pinguinonice/BetaBMI055/README.md

# BetaBMI055
IMU WiFi-Sensorboard - BETA

Das Sensorboard ermöglicht es Beschleunigungen und Drehraten des BMI055 IMU Sensors  kabellos, über ein WiFi-Netzwerk zu übertragen. Die Stromversorgung erfolgt durch einen Lithium-Polymer Akku und lässt so einen Messbetrieb über mehrere Stunden zu. Der Ladestand des Akkus kann ebenfalls ausgelesen und übertragen werden. Als Microcontroler und WiFi-Modul dient ein ESP-12F. Als Lade- und Programmierschnittstelle dient ein Micro USB Anschluss. 2 LEDs können als Statusanzeige verwendet werden eine weitere dient als Ladeindikator.
In diesem Dokument soll gezeigt werden, wie Programme auf das Board mit Hilfe der Arduino IDE aufgespielt werden können. Ein Programmbeispiel 2 zur Übertragung der Messdaten an MATLAB liegt vor.
