pinguinonice/BetaBMI055/v2/main.tex

%%%%%%%%%%%%%%%%%%%%%%%%%%%%%%%%%%%%%%%%%
% Wenneker Article
% LaTeX Template
% Version 2.0 (28/2/17)
%
% This template was downloaded from:
% http://www.LaTeXTemplates.com
%
% Authors:
% Vel (vel@LaTeXTemplates.com)
% Frits Wenneker
%
% License:
% CC BY-NC-SA 3.0 (http://creativecommons.org/licenses/by-nc-sa/3.0/)
%
%%%%%%%%%%%%%%%%%%%%%%%%%%%%%%%%%%%%%%%%%

%----------------------------------------------------------------------------------------
%	PACKAGES AND OTHER DOCUMENT CONFIGURATIONS
%----------------------------------------------------------------------------------------

\documentclass[10pt, a4paper, onecolumn]{article} % 10pt font size (11 and 12 also possible), A4 paper (letterpaper for US letter) and two column layout (remove for one column)

\input{structure.tex} % Specifies the document structure and loads requires packages
\usepackage{units}   % für nicht-kursive Einheiten
%----------------------------------------------------------------------------------------
%	ARTICLE INFORMATION
%----------------------------------------------------------------------------------------

\title{IMU WiFi-Sensorboard - BETA} % The article title

\author{
	\authorstyle{Karsten Schäfer\textsuperscript{1,3}, Bernhardt Schäfer\textsuperscript{1,2}, Markus Mroch\textsuperscript{1,3} und Philipp Schneider\textsuperscript{1,2}} % Authors
	\newline\newline % Space before institutions
\textsuperscript{1}\institution{Universität Stuttgart}\\ % Institution 1
\textsuperscript{2}\institution{Institut für Navigation} \\
\textsuperscript{3}\institution{Institut für Sportwissenschaften} % Institution 3
}

% Example of a one line author/institution relationship
%\author{\newauthor{John Marston} \newinstitution{Universidad Nacional Autónoma de México, Mexico City, Mexico}}

\date{\today} % Add a date here if you would like one to appear underneath the title block, use \today for the current date, leave empty for no date

%----------------------------------------------------------------------------------------

\begin{document}

\maketitle % Print the title

\thispagestyle{firstpage} % Apply the page style for the first page (no headers and footers)

%----------------------------------------------------------------------------------------
%	ABSTRACT
%----------------------------------------------------------------------------------------

Das Sensorboard ermöglicht es Beschleunigungen und Drehraten des BMI055 IMU Sensors (\ref{BMI055}) kabellos, über ein WiFi-Netzwerk zu übertragen. Die Stromversorgung erfolgt durch einen Lithium-Polymer Akku und lässt so einen Messbetrieb über mehrere Stunden zu. Der Ladestand des Akkus kann ebenfalls ausgelesen und übertragen werden. Als \emph{Microcontroler} und WiFi-Modul dient ein ESP-12F (\ref{ESP-12F}). Als Lade- und Programmierschnittstelle dient ein \emph{Micro USB Anschluss}  2 LEDs können als Statusanzeige verwendet werden eine weitere dient als Ladeindikator. 

In diesem Dokument soll gezeigt werden, wie Programme auf das Board mit Hilfe der Arduino IDE aufgespielt werden können. Ein Programmbeispiel \ref{Beispiele}  zur Übertragung der Messdaten an MATLAB liegt vor.

%----------------------------------------------------------------------------------------
%	ARTICLE CONTENTS
%----------------------------------------------------------------------------------------

\tableofcontents

\clearpage
\section{Aufbau}

Das Sensorboard wurde entworfen um zwei verschiedene MEMS IMU Sensoren benutzen zu können. Die hier beschrieben Variante ist ausschließlich mit dem Bosch BMI055 \cite{BMI055} bestückt. 

%------------------------------------------------

\subsection{Übersicht}
\begin{figure}[h]
	\centering
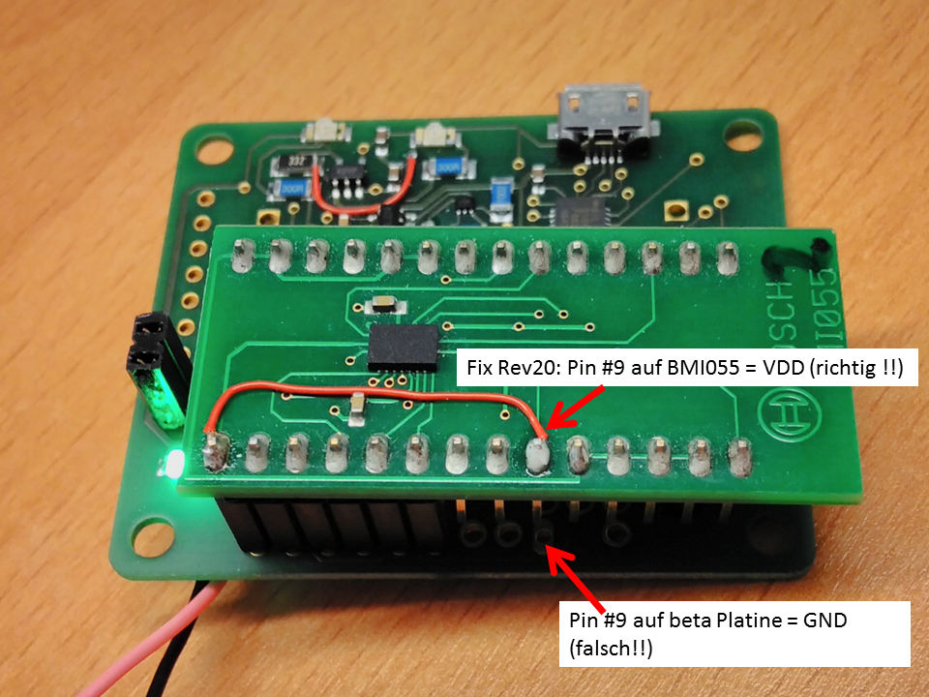
[picture p1: v2/images/BetaICMRev020fix.png]
	
	\caption{Übersicht mit nachträglichen Verbindungen}
	\label{fotoBeta}
\end{figure}

\clearpage
%------------------------------------------------

\subsection{Schaltplan}
Abbildung \ref{schematicBeta} zeigt den Schaltplan des Sensorboards. Zu beachten ist, dass der Sensor \emph{ICM2061 } nicht bestückt ist.\\ \textbf{$I^2C$ Betrieb}    GPIO4 = SDA und GPIO5 =SCL  
\begin{figure}[h]
	\centering
	
	\caption{Schaltplan des Sensorboards (ICM2061 ist nicht bestückt)}
	\label{schematicBeta}
\end{figure}

\clearpage

\subsection{Platine}
Abbildung \ref{platineBeta} zeigt die Abmessungen und den Aufbau der Platine

\begin{table}[h]
	\begin{tabular}{ll}
	
		~  & Bezeichnung\\
		\midrule
		1 & ESP-12F (\ref{ESP-12F})  \\
		2 & Fuelegauge (\ref{fuelgauge}) \\
		3 & LED D2 (\ref{LEDs})  \\
		4 & Reset (\ref{reset})  \\
		5 & FTDI Anschluss (\ref{FTDI}) \\
		6 & LED D1 (\ref{LEDs})  \\
		7 & Micro USB Anschluss  \\
		8 & CP2104 (\ref{CP2104}) \\
		9 & LED D3 (\ref{LEDs})  \\
		10 & Solderbridge (\ref{CP2104})  \\
		\bottomrule
	\end{tabular}
\end{table}

\begin{figure}[h]
	\centering
	
	\caption{Platinen Layout ohne Sensor. \colorbox{red}{ROT}=Oben,\colorbox{blue}{Blau}=Unten, \colorbox{Green}{Grün}=Durchkontaktierung}
	\label{platineBeta}
\end{figure}

%------------------------------------------------
\clearpage

\section{Beispielanwendung} \label{Beispiele}
Im Folgenden sollen ein paar Beispiel Anwendungen gezeigt werden. Um den Code auf das Sensorboard zu \emph{Flashen} wird die Arduino IDE benötigt. Für Arduino Projekte gibt es eine große \emph{Community}, sodass die meisten Probleme durch einer kurzen Internetrecherche lösbar sind. 

\subsection{LED Test}
Der folgende Arduino Sketch testet die Funktion der LEDs.
Die Pins GPIO0 GPIO2 und GPIO13 dienen hierbei als Sink für die LED, d.h. LOW = An.\\
GPI014 muss für den Batteriebetrieb HIGH sein.
\lstinputlisting[style=Arduino]{code/Blink2LED02/Blink2LED02.ino}

\subsection{I$^2$C Scanner}

Dieser Sketch kann verwendet werden um nach über den $I^2C$-Bus angeschlossenen Sensoren zu Suchen. Im Serial Monitor der ARDUINO IDE  sollten folgende Adressen gefunden werden 0x18, 0x68 und 0x36 das sind Beschleunigungssensor \& Gyroskop (\ref{BMI055}) und Fuelgauge (\ref{fuelgauge}).

\lstinputlisting[style=Arduino]{code/i2cScanner/i2cScanner.ino}

\subsection{Übertragen des Signals via Wi-Fi}
Eine Möglichkeit die Messdaten auf einen Computer mit Matlab zu übertragen soll hier gezeigt werden.
Der Computer und der Sensor müssen imselben WiFi Netzwerk sein (z.B. WiFi-Hotspot mit Handy). Um den Sensor mit dem gewünschten Netz zu verbinden müssen im Sketch SSID und Passwort (Zeile 27-28) angepasst werden. Nach einem Reset wird über den Seriellen Monitor der Status der Verbindung angegeben. Ist der Sensor verbunden, leuchtet die grüne LED.
Das Matlab file sollte die eingehenden UDP Verbindungen Verarbeiten. 

\subsubsection{Übertragungsstruktur}
Jede Messung besteht aus 16 Byte. int32 (4 Byte) für die Zeit int16 (2  Byte) für die Beschleunigung jeder Achse und  int16 (2 Byte) für die Drehrate jeder Achse.   \\
Es werden immer 10 Messungen gemeinsam mit der Signalstärke des Wi-Fis (int32 4 Byte) und dem Ladezustand der Batterie (int8 1 Byte) übertragen, sodass das gesammte Packet $16 \cdot 10 + 5 = $ 165 Byte lang ist.\\
{\tiny 
\begin{tabular}{llllllllllllllllllllll} \toprule
	{1} & {2} & {3} & {4} & {5} & {6} & {7} & {8} & {9} & {10} & {11} & {12} & {13} & {14} & {15} & {16}& {...} &{161}& {162} & {163} & {164} & {165} \\ \midrule
	{$t_1$} & {$t_2$} & {$t_3$} & {$t_4$} & {$ax_1$} & {$ax_2$} & {$ay_1$} & {$ay_2$} & {$az_1$} & {$az_2$} &  {$ax_1$} & {$gx_2$} & {$gy_1$} & {$gy_2$} & {$gz_1$} & {$gz_2$}& {...} & {$wifi_1$} & {$wifi_2$} & {$wifi_3$} & {$wifi_4$} & {bat}\\  \bottomrule
\end{tabular}}
 {\normalsize }\\
 
 Die Werte werden im Matlab Skript  (Zeile 40-50) zusammengesetzt.
\subsubsection{Matlab Code}

\definecolor{gray}{rgb}{0.95,0.95,0.95}
\definecolor{mgreen}{rgb}{0.1,0.5,0.1}  %Matlab-Grün
\lstset{
	breaklines=true,
	inputencoding="latin1",
	backgroundcolor=\color{gray},
	basicstyle=\scriptsize\ttfamily,
	commentstyle=\color{mgreen}\ttfamily,
	emph={square}, 
	emphstyle=\color{blue}\texttt,
	emph={[2]root,base},
	emphstyle={[2]\color{yac}\texttt},
	showstringspaces=false,
	flexiblecolumns=false,
	tabsize=4,
	numbers=left,
	numberstyle=\tiny,
	numberblanklines=false,
	stepnumber=1,
	numbersep=10pt,
	xleftmargin=15pt
}
\lstinputlisting[language=matlab]{code/betareadout/betareadout.m}

\subsubsection{ Arduino Sketch}
Dieser Sketch 
\lstinputlisting[style=Arduino]{code/test_BETA/test_BETA.ino}

\section{Komponenten}

\subsection{ESP-12F}
\label{ESP-12F}
Das ESP8266 Modul ist ein Ultra-low-Power-32-Bit-Mikrocontroller.  Integriertes WLAN ermöglicht die Kommunikation nach Außen.  
Die Programmierung kann z.B. über die ARDUINO-IDE vorgenommen werden. Die Sensoren (IMU, Batteriestand) sind über einen $I^2C$-Bus angeschlossen.
\begin{description}
	\item[WiFi Protocles] 802.11 b/g/n
	\item[Frequency Range ] 2.4GHz-2.5GHz (2400M-2483.5M)
	\item[Security] WPA/WPA2  WEP/TKIP/AES
	\item[Stromverbrauch] 80 mA
	\item[Network Protocols] IPv4, TCP/UDP/HTTP/FTP
\end{description}
\subsection{BMI055}
\label{BMI055}
Der BOSCH BMI055 ist eine Inertiale Messeinheit (IMU) und somit  eine räumliche Kombination von Beschleunigungssensoren  und Drehratensensoren. Die Messungen erfolgen in x-, y- und z- Richtung und realisieren so  6 Freiheitsgrade (6DoF). 

\paragraph{Accelerometer}
\begin{description}
	\item[I2C Adresse] 0x18
	\item[Auflösung] 12bit
	\item[Messbereich ] Programmierbar:  ±2g/±4g/±8g/±16g
	\item[Stromverbrauch] 130 $\mu$A
\end{description}
\paragraph{Gyroskop}
\begin{description}
\item[I2C Adresse] 0x68
\item[Auflösung] 16bit
\item[Messbereich ] Programmierbar:  ±125°/s to ±2000°/s
\item[Stromverbrauch] 5mA 
\end{description}
\subsection{Fuelgauge}
\label{fuelgauge}
Der Batteriestandsanzeiger MAX17048 bietet die Möglichkeit den Ladestand eines LiPo-Akkus (1 Zelle, 3.7V) in Prozent abzufragen.  Interne wird die Spannung in eine einem Model in Prozent umgerechnet, dabei werden spezifische Effekte der Batterie, wie Temperatur und Spannungskurve berücksichtigt.
\begin{description}
		\item[I2C Adresse] 0x36
	\item[Precision]  ±7.5mV
	\item[Stromverbrauch] <23$\mu$A
\end{description}

\subsection{LEDs}
\label{LEDs}
Das Board verfügt über 3 LEDs von denen 2 über die GPIOs des ESP8266 Moduls frei programmierbar sind. Eine LED ist als Ladeindikator vorgesehen.

\begin{table}[h]
	\caption{LEDs}
	\centering
	\begin{tabular}{llr}
		Name & Anschluss & Farbe \\
		\midrule
		D1 & GPIO0 & ??? \\
		D2 & GPIO13 & ??? \\
		D3 & Ladestand & ??? \\
		\bottomrule
	\end{tabular}
\end{table}

LED D1 blinkt wenn Kommunikation über die UART Schnittstelle stattfindet.

\subsection{CP2104 }
\label{CP2104}
CP2104 Chip als USB/UART Bridge für die Programmierung. Treiber sind für alle gängigen Betriebssystem vorhanden. RXD und TXD können ggf. manuell getrennt werden (Siehe \emph{Solderbridge} Abb. \ref{platineBeta}).

\subsection{FTDI Anschluss }
\label{FTDI}
Anschluss für 5 Volt FTDI Kabel (GND, CTS, VCC, TXD, RXD, RTS). Kann auch zum laden des Akkus verwendet werden.

\subsection{Reset}
\label{reset}
\blindtext

\section{Anhang}
\subsection{Bibliotheken}
\subsubsection{BMI055}
\lstinputlisting[style=arduino]{code/test_BETA/BMI055.cpp}
\subsubsection{BMI055.h}
\lstinputlisting[style=arduino]{code/test_BETA/BMI055.h}

\subsubsection{I2Cdev}
https://github.com/jrowberg/i2cdevlib/blob/master/Arduino/I2Cdev/I2Cdev.h
\subsubsection{MAX17048}
https://github.com/libpropeller/libpropeller/blob/master/libpropeller/max17048/max17048.h
%----------------------------------------------------------------------------------------
%	BIBLIOGRAPHY
%----------------------------------------------------------------------------------------
\printbibliography[title={Datenblätter}] % Print the bibliography, section title in curly brackets

%----------------------------------------------------------------------------------------

\end{document}
