pinguinonice/BetaBMI055/v2/main.pdf

# IMU WiFi-Sensorboard - BETA

## Karsten Schafer ¨

## 1,3, Bernhardt Schafer ¨

## 1,2, Markus Mroch¹,3 und Philipp Schneider¹,2

1Universitat Stuttgart ¨

2
Institut fur Navigation ¨
3
Institut fur Sportwissenschaften ¨

## October 24, 2017

Das Sensorboard ermöglicht es Beschleunigungen und Drehraten des BMI055 IMU Sensors (3.2) kabellos, über ein WiFi-Netzwerk zu übertragen. Die Stromversorgung erfolgt durch einen Lithium-Polymer Akku und lässt so einen Messbetrieb über mehrere Stunden zu. Der Ladestand des Akkus kann ebenfalls ausgelesen und übertragen werden. Als Microcontroler und WiFi-Modul dient ein ESP-12F (3.1). Als Lade- und Programmierschnittstelle dient ein Micro USB Anschluss 2 LEDs können als Statusanzeige verwendet werden eine weitere dient als Ladeindikator. In diesem Dokument soll gezeigt werden, wie Programme auf das Board mit Hilfe der Arduino IDE aufgespielt werden können. Ein Programmbeispiel 2 zur Übertragung der Messdaten an MATLAB liegt vor.

# Contents

1 Aufbau | 2
2 Beispielanwendung | 5
3 Komponenten | 10
4 Anhang | 11

## IMU WiFi-Sensorboard - BETA

### 4.1.4 BMI055.h | 38

# 1 Aufbau

Das Sensorboard wurde entworfen um zwei verschiedene MEMS IMU Sensoren benutzen zu können. Die hier beschrieben Variante ist ausschließlich mit dem Bosch BMI055 [1] bestückt.

## 1.1 Ubersicht ¨

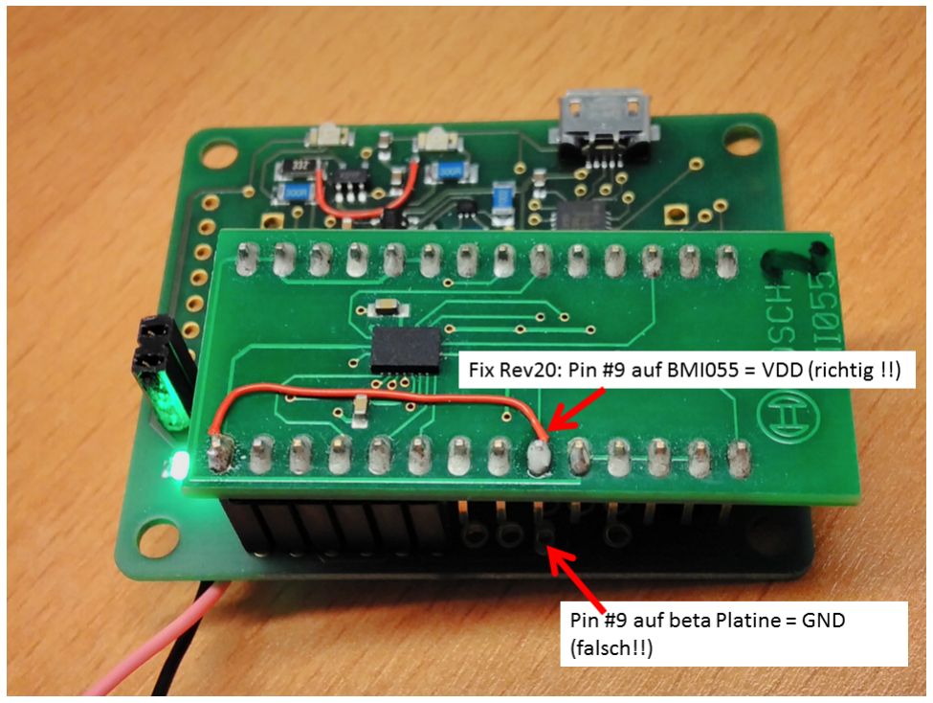
[picture p2: figure]

### Abb. 1: Übersicht mit nachträglichen Verbindungen

## 1.2 Schaltplan

Abbildung 2 zeigt den Schaltplan des Sensorboards. Zu beachten ist, dass der Sensor ICM2061 nicht bestückt ist.

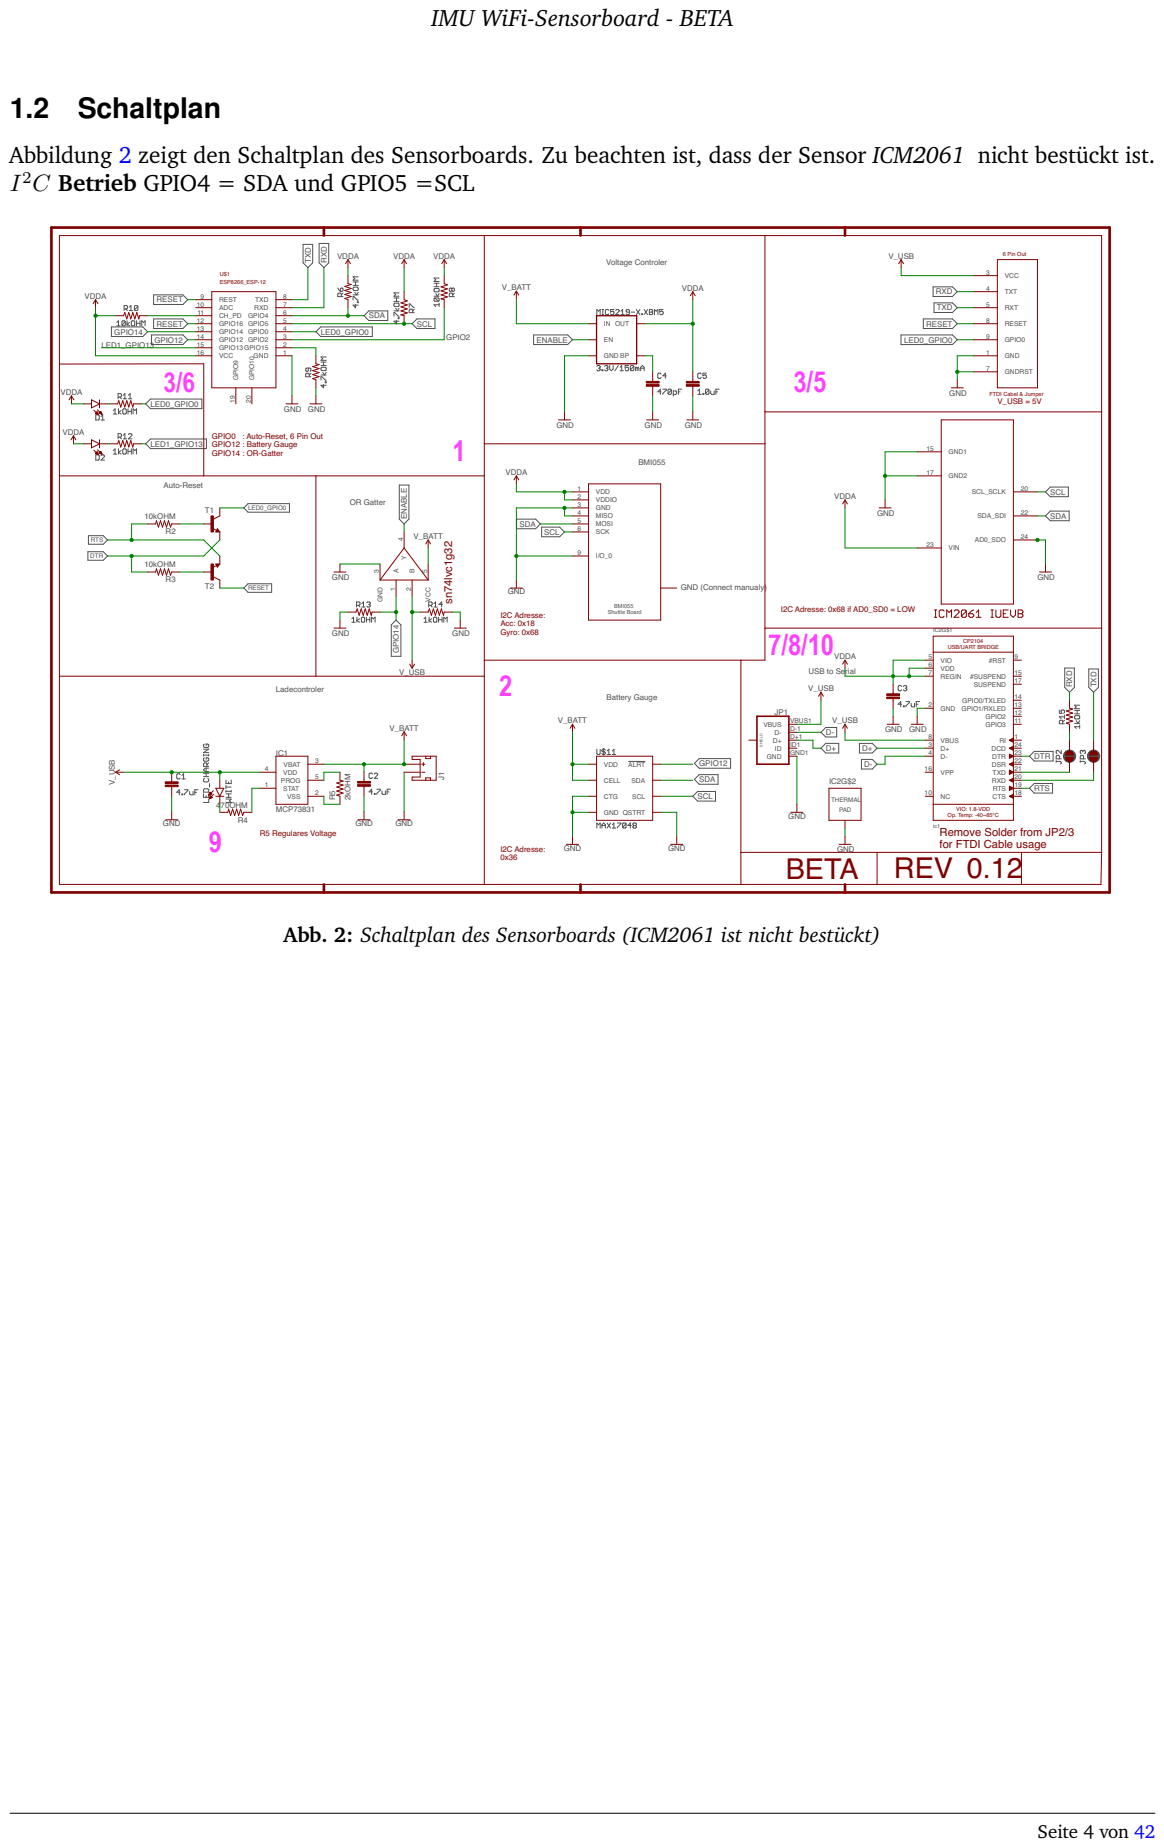
[picture p3: page 4]
MCP73831; GND; V_USB; V_BATT; 2kOHM; 470OHM; 10kOHM; VDDA; GND GND; BMI055; Ladecontroler; Auto-Reset; Battery Gauge; Voltage Controler; OR Gatter; VDD 4; STAT 1; VBAT; PROG; VSS; ALRT; CELL; CTG; GND QSTRT; SCL; SDA; VDD; VCC 5; GND 3; GND1 ID; VBUS; VBUS1; SHIELD; OUT; #RST; #SUSPEND; CTS; DCD; DSR; 22 DTR; GND 2; GPIO0/TXLED; GPIO1/RXLED; GPIO2; GPIO3; REGIN 7; RTS; 19 RXD; SUSPEND; TXD; VBUS 8; VDD 6; VIO 5; VPP 16; THERMAL; PAD; GND1 15; GND2 17; SCL_SCLK; SDA_SDI; VIN 23; AD0_SDO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

2C Betrieb GPIO4 = SDA und GPIO5 =SCL

FTDI Cabel & Jumper
V_USB = 5V

GPIO0 : Auto-Reset, 6 Pin Out
GPIO12 : Battery Gauge
GPIO14 : OR-Gatter

GND (Connect manualy)

I2C Adresse: 0x68 if AD0_SD0 = LOW I2C Adresse:
Acc: 0x18
Gyro: 0x68

USB/UART BRIDGE

USB to Serial

VIO: 1.8-VDD
Op. Temp: -40~85°C
Remove Solder from JP2/3
for FTDI Cable usage

Abb. 2: Schaltplan des Sensorboards (ICM2061 ist nicht bestückt)

## 1.3 Platine

### Abbildung 3 zeigt die Abmessungen und den Aufbau der Platine

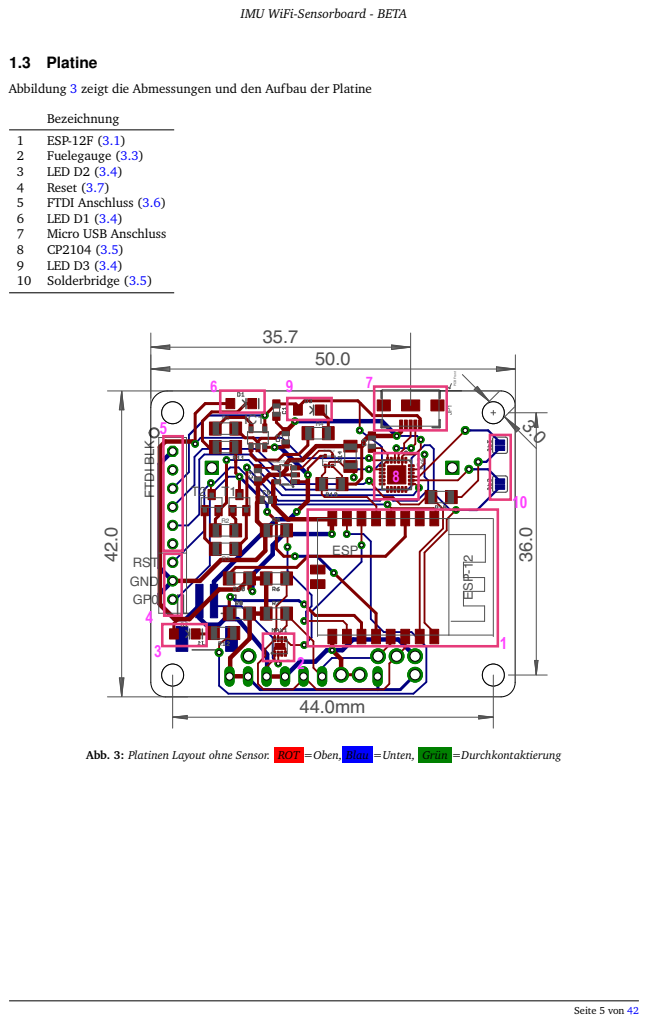
[picture p4: page 5]

Abb. 3: Platinen Layout ohne Sensor. ROT =Oben, Blau =Unten, Grün =Durchkontaktierung

# 2 Beispielanwendung

Im Folgenden sollen ein paar Beispiel Anwendungen gezeigt werden. Um den Code auf das Sensorboard zu Flashen wird die Arduino IDE benötigt. Für Arduino Projekte gibt es eine große Community, sodass die meisten Probleme durch einer kurzen Internetrecherche lösbar sind.

## 2.1 LED Test

Der folgende Arduino Sketch testet die Funktion der LEDs. Die Pins GPIO0 GPIO2 und GPIO13 dienen hierbei als Sink für die LED, d.h. LOW = An.
GPI014 muss für den Batteriebetrieb HIGH sein.
1 | #d e fi n e LED0 0
2 | #d e fi n e LED1 2
3 | #d e fi n e LED2 13
4 | #d e fi n e GPIO14_OR 14

5

6
7 | void se tup ( ) {
8 | pinMode (LED0 , OUTPUT) ;
9 | pinMode (LED1 , OUTPUT) ;
10 | pinMode (LED2 , OUTPUT) ;
11 | pinMode (GPIO14_OR , OUTPUT) ;
12 | d i g i t a l W r i t e (GPIO14_OR , HIGH) ; | // always on
13 | S e r i a l . begin (115200) ;
14 | }

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

39
40 }

## 2.2 I²C Scanner

### Dieser Sketch kann verwendet werden um nach über den I

### 2C-Bus angeschlossenen Sensoren zu Suchen. Im

Serial Monitor der ARDUINO IDE sollten folgende Adressen gefunden werden 0x18, 0x68 und 0x36 das sind Beschleunigungssensor & Gyroskop (3.2) und Fuelgauge (3.3).

1
2 | //
3 | // Thi s s ke t c h t e s t s the s t and a rd 7−b i t a d d re s se s
4 | // Devi ce s wi th hi g he r b i t add re s s might no t be seen p r o p e rl y .
5 | //

6
7 | #i n cl u d e <Wire . h> // i 2 c l i b a r y

8

9
10 | void se tup ( )
11 | {

12 | Wire . begin (5 ,4 ) ; // i 2 c Bus : | GPIO5 =SCL und GPIO4 = SDA

13

14

15
16 | S e r i a l . begin (9600) ; | // S e r i a l Moni tor mi t 9699 Baut Ra te
17 | while ( ! S e r i a l ) ; | // Leonardo : wai t f o r s e r i a l moni tor
18 | S e r i a l . p r i n t l n ( " \nI2C Scanner " ) ;
19 | }

20

21
22 | void loop ( )
23 | {
24 | by te e r r o r , add re s s ;
25 | i n t nDevice s ;

26
27 | S e r i a l . p r i n t l n ( " Scanning . . . " ) ;

28
29 | nDevice s = 0 ;
30 | f o r ( add re s s = 1 ; add re s s < 127 ; add re s s++ )
31 | {
32 | // The i 2 c _ s c a n ne r u se s the r e t u r n v alue o f
33 | // the W ri te . endT r an smi s s ti on t o see i f
34 | // a devi ce did acknowledge t o the add re s s .
35 | Wire . be ginT r an smi s si on ( add re s s ) ;
36 | e r r o r = Wire . endT ran smi s sion ( ) ;

37
38 | i f ( e r r o r == 0)
39 | {
40 | S e r i a l . p r i n t ( " I2C devi ce found a t add re s s 0x " ) ;
41 | i f ( add ress <16)
42 | S e r i a l . p r i n t ( " 0 " ) ;
43 | S e r i a l . p r i n t ( add ress , HEX) ;
44 | S e r i a l . p r i n t l n ( " | ! " ) ;

45
46 | nDevice s++;
47 | }
48 | e l s e i f ( e r r o r==4)
49 | {
50 | S e r i a l . p r i n t ( "Unknow e r r o r a t add re s s 0x " ) ;
51 | i f ( add ress <16)
52 | S e r i a l . p r i n t ( " 0 " ) ;
53 | S e r i a l . p r i n t l n ( add ress , HEX) ;
54 | }
55 | }
56 | i f ( nDevice s == 0)
57 | S e r i a l . p r i n t l n ( "No I2C d e vi c e s found\n " ) ;
58 | e l s e
59 | S e r i a l . p r i n t l n ( " done\n " ) ;

60
61 | del ay (5000) ; | // wai t 5 seconds f o r ne x t scan
62 | }

## 2.3 Ubertragen des Signals via Wi-Fi ¨

Eine Möglichkeit die Messdaten auf einen Computer mit Matlab zu übertragen soll hier gezeigt werden. Der Computer und der Sensor müssen imselben WiFi Netzwerk sein (z.B. WiFi-Hotspot mit Handy). Um den Sensor mit dem gewünschten Netz zu verbinden müssen im Sketch SSID und Passwort (Zeile 27-28) angepasst werden. Nach einem Reset wird über den Seriellen Monitor der Status der Verbindung angegeben. Ist der Sensor verbunden, leuchtet die grüne LED. Das Matlab file sollte die eingehenden UDP Verbindungen Verarbeiten.

## 2.3.1 Ubertragungsstruktur ¨

Jede Messung besteht aus 16 Byte. int32 (4 Byte) für die Zeit int16 (2 Byte) für die Beschleunigung jeder Achse und int16 (2 Byte) für die Drehrate jeder Achse.
Es werden immer 10 Messungen gemeinsam mit der Signalstärke des Wi-Fis (int32 4 Byte) und dem Ladezustand
der Batterie (int8 1 Byte) übertragen, sodass das gesammte Packet 16 · 10 + 5 = 165 Byte lang ist.
1 | 2 | 3 | 4 | 5 | 6 | 7 | 8 | 9 | 10 | 11 | 12 | 13 | 14 | 15 | 16 | ... | 161 | 162 | 163 | 164 | 165
t1 | t2 | t3 | t4 | ax1 | ax2 | ay1 | ay2 | az1 | az2 | ax1 | gx2 | gy1 | gy2 | gz1 | gz2 | ... | wif i1 | wif i2 | wif i3 | wif i4 | bat
Die Werte werden im Matlab Skript (Zeile 40-50) zusammengesetzt.

## 2.3.2 Matlab Code

1 | clear all
2 | clear all
3 | close all
4 | % Variablen initialisieren und Fenster oeffnen
5 | port =7000; % <--- Hier eigenen Port definiern ( Wie in Arduino Skript )
6 | figure
7 | text (0.5 ,0.5 , strcat ( ’ Waiting for input on Port : ’, num2str ( port ))) ;
8 | drawnow
9 | dataraw = zeros (1 ,165 , ’ uint8 ’);
10 | messung = zeros (1000 ,7 , ’ int32 ’) ;
11 | % UTP Port defenieren
12 | udpr = dsp . UDPReceiver ( ’ LocalIPPort ’, port );
13 | % Auf Daten von Port warten und holen , wenn vorhanden
14 | while true
15 | dataraw = zeros (1 ,165 , ’ uint8 ’);
16 | while size ( dataraw ,1) <2
17 | dataraw = udpr () ;
18 | end
19 | % Ladezustand und Signalstaerke entpacken
20 | perc = dataraw (165) ;
21 | wifi = typecast ( uint8 ( dataraw ( end -4: end -1) ) , ’ int32 ’);
22 | %10 Messungen a 16 byte =160 x1 Vektoer in | 10 x16 Array umformen
23 | data = reshape ( dataraw (1:160) ,16 ,10) ’;
24 | % Bytes wieder zu Werten zusammensetzen
25 | for i =1:10;
26 | time (i ) = typecast ( uint8 ( data (i ,1:4) ) , ’ int32 ’);
27 | acc (i ,1) = typecast ( uint8 ( data (i ,5:6 )) , ’ int16 ’);
28 | acc (i ,2) = typecast ( uint8 ( data (i ,7:8 )) , ’ int16 ’);
29 | acc (i ,3) = typecast ( uint8 ( data (i ,9:10) ) , ’ int16 ’);
30 | gyro (i ,1) = typecast ( uint8 ( data (i ,11:12) ) , ’ int16 ’);
31 | gyro (i ,2) = typecast ( uint8 ( data (i ,13:14) ) , ’ int16 ’);
32 | gyro (i ,3) = typecast ( uint8 ( data (i ,15:16) ) , ’ int16 ’);
33 | end
34 | % Die aeltesten 10 Messungen loeschen und die Neuen 10 hinzufuegen
35 | messung (1:10 ,:) =[];
36 | messung ( end +1: end +10 ,:) =[ time ’ acc gyro ];
37 | %% Darstellung
38 | % Beschleunigung
39 | subplot (3 ,1 ,1)
40 | title ( ’ Beschleunigung ’)
41 | hold on
42 | p1 = plot ( messung (: ,1) , messung (: ,2) , ’r ’);
43 | p2 = plot ( messung (: ,1) , messung (: ,3) , ’g ’);
44 | p3 = plot ( messung (: ,1) , messung (: ,4) , ’b ’);
45 | axis ([ messung (1 ,1) , messung ( end ,1) , -5000 5000]) ;
46 | % Drehraten
47 | subplot (3 ,1 ,2)
48 | title ( ’ Drehraten ’)
49 | hold on
50 | p1 = plot ( messung (: ,1) , messung (: ,5) , ’r ’);
51 | p2 = plot ( messung (: ,1) , messung (: ,6) , ’g ’);
52 | p3 = plot ( messung (: ,1) , messung (: ,7) , ’b ’);
53 | axis ([ messung (1 ,1) , messung ( end ,1) , -5000 5000]) ;
54 | % Wifi und Signalstaerke
55 | subplot (3 ,1 ,3)
56 | title ( ’ Telemetrie ’)
57 | hold on
58 | b1 = bar ([1 2] , [2*( wifi +100) | perc ]) ;
59 | xticklabels ({ ’ wifi ’,’ battery ’})
60 | ylabel ( ’% ’)
61 | % Zeichnen der Plots
62 | drawnow
63 | delete ( p1 ) ;
64 | delete ( p2 ) ;
65 | delete ( p3 ) ;
66 | delete ( b1 ) ;
67 | end

## 2.3.3 Arduino Sketch

### Dieser Sketch

1 | #i n cl u d e <ESP8266WiFi . h>
2 | #i n cl u d e <WiFiUdp . h>
3 | #i n cl u d e <s t d i o . h>
5 | #i n cl u d e " Wire . h "
6 | #i n cl u d e " I2Cdev . h "
7 | #i n cl u d e "MAX17048 . h "
8 | #i n cl u d e " BMI055 . h "
9 | // BMI055 d e f a u l t I2C add re s s i s 0x18 and 0x68
10 | BMI055 imu ;
11 | // MAX17048 d e f a u l t I2C add re s s i s 0x36

12 | MAX17048 l i p o ;
14 | WiFiUDP Udp ;
16 | #d e fi n e LED_R | 0 | // red
17 | #d e fi n e LED_G | 13 | // green
18 | #d e fi n e LED_B | 2 | // blue onboard ESP8266−12F
19 | #d e fi n e ON_PIN | 14 | // GPIO14 muss high , s o n s t Notaus
21 | #d e fi n e SSID | " i Pi p p o "
22 | #d e fi n e PW | " h all o w el t "
23 | #d e fi n e TARGET_IP " 172.20.10.4 "
24 | #d e fi n e TARGET_PORT 7000
25 | #d e fi n e MESSAGE_SIZE 255
27 | ui n t 8 _ t da ta [32000] ;
28 | ui n t 1 6 _ t c oun te r = 0 ;
30 | bool e r r o r = f a l s e ;
31 | ui n t 3 2 _ t e r r o rT ;
33 | union B y t e S pli t 2 {
34 | i n t 1 6 _ t i n ;
35 | s t r u c t S {
36 | by te b1 , b2 ;
37 | } ou t ;
38 | } ;
39 | union B y t e S pli t 4 {
40 | ui n t 3 2 _ t i n ;
41 | s t r u c t S {
42 | by te b1 , b2 , b3 , b4 ;
43 | } ou t ;
44 | } ;
46 | void se tup ( ) {
47 | Wire . begin (5 , 4) ;
48 | S e r i a l . begin (115200) ;
49 | S e r i a l . p r i n t l n ( " b o o tin g . . . " ) ;
50 | S e r i a l . p r i n t ( " Connec ting t o " SSID ) ;
51 | WiFi . begin ( SSID , PW) ;
52 | while ( WiFi . s t a t u s ( ) != WL_CONNECTED) {
53 | del ay (500) ;
54 | S e r i a l . p r i n t ( " . " ) ;
55 | }
56 | S e r i a l . p r i n t l n ( ) ;
57 | S e r i a l . p r i n t ( " Connected , IP add re s s : " ) ;
58 | S e r i a l . p r i n t l n ( WiFi . l o c a l I P ( ) ) ;
60 | imu . i n i t i a l i z e ( ) ;
62 | i f ( ! imu . t e s tC o n n e c ti o n ( ) ) {
63 | S e r i a l . p r i n t l n ( "IMU t e s t f a i l e d " ) ;
64 | del ay (100) ;
65 | ESP . r e s t a r t ( ) ;
66 | }
68 | // Con fi g Bandwidth and Range has t o be a dj u s t e d t o your e xpec ted measurments
69 | imu . se tRangeAcc (BMI055_ACC_RANGE_16G) ;
70 | imu . se tRangeGyr (BMI055_GYR_RANGE_2000) ;
72 | imu . se tBandwid thAcc (BMI055_ACC_BW_500) ;
73 | imu . se tBandwid thGyr (BMI055_GYR_BW_523) ;
75 | l i p o . i n i t i a l i z e ( ) ;
77 | pinMode (LED_R , OUTPUT) ;
78 | pinMode (LED_G , OUTPUT) ;
79 | pinMode ( LED_B , OUTPUT) ;
80 | pinMode (ON_PIN , OUTPUT) ;
81 | d i g i t a lW r i t e (LED_R , HIGH) ;
82 | d i g i t a lW r i t e (LED_G , LOW) ;
83 | d i g i t a lW r i t e ( LED_B , HIGH) ;
84 | d i g i t a lW r i t e (ON_PIN , HIGH) ;
85 | }

87 | void loop ( ) {
88 | B y t e S pli t 4 t ;
89 | t . i n = ( ui n t 3 2 _ t ) m i l l i s ( ) ;
90 | // | t . i n = 12313;
91 | da ta [ c oun te r++] = t . ou t . b1 ;
92 | da ta [ c oun te r++] = t . ou t . b2 ;
93 | da ta [ c oun te r++] = t . ou t . b3 ;
94 | da ta [ c oun te r++] = t . ou t . b4 ;
96 | imu . g e t A c c e l e r a t i o n (& da ta [ c oun te r++], &da ta [ c oun te r++], &da ta [ c oun te r++], &da ta [ c oun te r++], &
| | da ta [ c oun te r++], &da ta [ c oun te r++]) ;
99 | imu . ge tTu rnRa te (& da ta [ c oun te r++], &da ta [ c oun te r++], &da ta [ c oun te r++], &da ta [ c oun te r++], &da ta [
c oun te r++], &da ta [ c oun te r++]) ;
101 | i f ( c oun te r >= 160) { //160 e q u al s 10x ( 2by te *6 s e n s o r s + 4by te time )
102 | se n dB u f fe r ( ) ;
103 | c oun te r = 0 ;
104 | }
105 | }
107 | bool se n dB u f fe r ( ) {
108 | i n t 8 _ t pe rc = ( i n t ) ( l i p o . getSOC ( ) | * MAX17048_SOC_SCALE) ;
109 | ui n t 8 _ t v b a t t = ( i n t ) ( l i p o . getVCELL ( ) * MAX17048_VCELL_SCALE * 10) ;
110 | bool okay = t r u e ;
112 | B y t e S pli t 4 s ;
113 | s . i n = WiFi . RSSI ( ) ;
114 | da ta [ c oun te r++] = s . ou t . b1 ;
115 | da ta [ c oun te r++] = s . ou t . b2 ;
116 | da ta [ c oun te r++] = s . ou t . b3 ;
117 | da ta [ c oun te r++] = s . ou t . b4 ;
118 | da ta [ c oun te r++] = pe rc ;
120 | f o r ( ui n t 8 _ t i T r y = 0 ; i T r y < 10 ; i T r y++) {
121 | okay = sendUDP ( data , coun te r , TARGET_PORT) ;
122 | i f ( okay == t r u e )
123 | break ;
124 | del ay (1) ;
125 | }
126 | i f ( okay == f a l s e ) {
127 | del ay (0) ;
128 | by te msg[32] = " f i n n a l y f a i l e d t o send message \n " ;
129 | sendUDP (msg , 32 , 7001) ;
130 | S e r i a l . p r i n t l n ( " f i n n a l y f a i l e d t o send message \n " ) ;
131 | d i g i t a l W r i t e (LED_R , LOW) ;
132 | e r r o r = t r u e ;
133 | e r r o rT = ( ui n t 3 2 _ t ) m i l l i s ( ) ;
134 | del ay (0) ;
135 | }
136 | e l s e i f ( e r r o r == t r u e && ( ( ui n t 3 2 _ t ) m i l l i s ( ) − e r r o rT ) >= 1000) {
137 | by te msg[50] = " f i n n a l y f a i l e d t o send message \n " ;
138 | sendUDP (msg , 32 , 7001) ;
139 | e r r o r = f a l s e ;
140 | d i g i t a l W r i t e (LED_R , HIGH) ;
141 | }
142 | c oun te r = 0 ;
143 | }
145 | bool sendUDP ( by te * t e s t , ui n t 8 _ t msgSize , ui n t 1 6 _ t p o r t ) {
146 | i f ( Udp . be gin P a c ke t (TARGET_IP , p o r t ) != 1 ) {
147 | r e t u r n f a l s e ;
148 | }
149 | Udp . w ri t e ( t e s t , msgSize ) ;
150 | i f ( Udp . endPacke t ( ) != 1) {
151 | r e t u r n f a l s e ;
152 | }
153 | r e t u r n t r u e ;
154 | }

# 3 Komponenten

## 3.1 ESP-12F

Das ESP8266 Modul ist ein Ultra-low-Power-32-Bit-Mikrocontroller. Integriertes WLAN ermöglicht die Kommunikation nach Außen. Die Programmierung kann z.B. über die ARDUINO-IDE vorgenommen werden. Die

### Sensoren (IMU, Batteriestand) sind über einen I

2C-Bus angeschlossen.

## WiFi Protocles 802.11 b/g/n

### Frequency Range 2.4GHz-2.5GHz (2400M-2483.5M) Security WPA/WPA2 WEP/TKIP/AES

## Stromverbrauch 80 mA

### Network Protocols IPv4, TCP/UDP/HTTP/FTP

## 3.2 BMI055

Der BOSCH BMI055 ist eine Inertiale Messeinheit (IMU) und somit eine räumliche Kombination von Beschleuni-gungssensoren und Drehratensensoren. Die Messungen erfolgen in x-, y- und z- Richtung und realisieren so 6 Freiheitsgrade (6DoF).

## Accelerometer

## I2C Adresse 0x18 Auflösung 12bit

### Messbereich Programmierbar: ±2g/±4g/±8g/±16g

## Stromverbrauch 130 µA

## Gyroskop

## I2C Adresse 0x68 Auflösung 16bit

### Messbereich Programmierbar: ±125°/s to ±2000°/s

## Stromverbrauch 5mA

## 3.3 Fuelgauge

Der Batteriestandsanzeiger MAX17048 bietet die Möglichkeit den Ladestand eines LiPo-Akkus (1 Zelle, 3.7V) in Prozent abzufragen. Interne wird die Spannung in eine einem Model in Prozent umgerechnet, dabei werden spezifische Effekte der Batterie, wie Temperatur und Spannungskurve berücksichtigt.

## I2C Adresse 0x36 Precision ±7.5mV Stromverbrauch <23µA

## 3.4 LEDs

Das Board verfügt über 3 LEDs von denen 2 über die GPIOs des ESP8266 Moduls frei programmierbar sind. Eine LED ist als Ladeindikator vorgesehen.

### Table 1: LEDs

Name | Anschluss | Farbe
D1 | GPIO0 | ???
D2 | GPIO13 | ???
D3 | Ladestand | ???

LED D1 blinkt wenn Kommunikation über die UART Schnittstelle stattfindet.

## 3.5 CP2104

CP2104 Chip als USB/UART Bridge für die Programmierung. Treiber sind für alle gängigen Betriebssystem vorhanden. RXD und TXD können ggf. manuell getrennt werden (Siehe Solderbridge Abb. 3).

## 3.6 FTDI Anschluss

Anschluss für 5 Volt FTDI Kabel (GND, CTS, VCC, TXD, RXD, RTS). Kann auch zum laden des Akkus verwendet werden.

## 3.7 Reset

Lorem ipsum dolor sit amet, consectetuer adipiscing elit. Etiam lobortis facilisis sem. Nullam nec mi et neque pharetra sollicitudin. Praesent imperdiet mi nec ante. Donec ullamcorper, felis non sodales commodo, lectus velit ultrices augue, a dignissim nibh lectus placerat pede. Vivamus nunc nunc, molestie ut, ultricies vel, semper in, velit. Ut porttitor. Praesent in sapien. Lorem ipsum dolor sit amet, consectetuer adipiscing elit. Duis fringilla tristique neque. Sed interdum libero ut metus. Pellentesque placerat. Nam rutrum augue a leo. Morbi sed elit sit amet ante lobortis sollicitudin. Praesent blandit blandit mauris. Praesent lectus tellus, aliquet aliquam, luctus a, egestas a, turpis. Mauris lacinia lorem sit amet ipsum. Nunc quis urna dictum turpis accumsan semper.

# 4 Anhang

## 4.1 Bibliotheken

## 4.1.1 BMI055

1 | // BMI055 I2C Cl a s s s ou rce
2 | // 2013/11/05 by Be rnha rd t Sch ae fe r , boen82@gmail . com
3 | // D a t a shee t : h t t p : / /www. bosch−s e n s o r t e c . com/en/homepage/ p roduc t s _3 /6 _ a xi s _ s e n s o r s _ 2 /
i ne r ti al _me a s u reme n t _ u ni t _ 1 /bmi055_1/bmi055
4 | // h t t p : / / ae−b s t . re s o u r ce . bosch . com/media/ p r odu c t s /dokumente/bmi055/BST−BMI055−DS000−06.pd f
5 | // Updates should ( h o p e f ull y ) always be a v a i l a b l e a t h t t p s : / / gi t hu b . com/ j rowbe rg / i 2 c d e v l i b
6 | //
7 | // Changelog :
8 | // | 2013/11/05 − i n i t i a l r e l e a s e
10 | /* ======================= ====================
11 | I2Cdev devi ce l i b r a r y code i s pl aced under the MIT l i c e n s e
12 | C opy ri gh t ( c ) 2011 J e f f Rowberg
14 | Pe rmi s si o n i s hereby gran ted , f r e e o f charge , t o any pe rson o b t ai ni n g a copy
15 | o f t h i s s o f tw a re and a s s o ci a t e d documen ta tion f i l e s ( the " So f twa re " ) , t o de al
16 | i n the So f twa re wi thou t r e s t r i c t i o n , i n cl u di n g wi thou t l i m i t a t i o n the r i g h t s
17 | t o use , copy , modify , merge , pu bli s h , d i s t r i b u t e , s u bli c e n s e , and/ or s e l l
18 | c o pi e s o f the So f tware , and t o pe rmi t pe r s on s t o whom the So f twa re i s
19 | f u r ni s h e d t o do so , s u b j e c t t o the f oll o wi n g c o n di ti o n s :
21 | The above c o p y ri g h t n o ti c e and t h i s pe rmi s si o n n o ti c e s h a l l be i n cl u de d i n
22 | a l l c o pi e s or s u b s t a n t i a l p o r ti o n s o f the So f twa re .
24 | THE SOFTWARE IS PROVIDED "AS IS " , WITHOUT WARRANTY OF ANY KIND , EXPRESS OR
25 | IMPLIED , INCLUDING BUT NOT LIMITED TO THE WARRANTIES OF MERCHANTABILITY ,
26 | FITNESS FOR A PARTICULAR PURPOSE AND NONINFRINGEMENT. IN NO EVENT SHALL THE
27 | AUTHORS OR COPYRIGHT HOLDERS BE LIABLE FOR ANY CLAIM , DAMAGES OR OTHER
28 | L IAB IL ITY , WHETHER IN AN ACTION OF CONTRACT, TORT OR OTHERWISE, ARISING FROM,
29 | OUT OF OR IN CONNECTION WITH THE SOFTWARE OR THE USE OR OTHER DEALINGS IN
30 | THE SOFTWARE.
31 ===============================================
32 | */
34 | #i n cl u d e " BMI055 . h "
36 | /*
37 | D e f a ul t C o n s t r u c t o r
38 | */
39 | BMI055 : : BMI055 ( ) {
40 | devAddrAcc | = BMI055_ACC_ADDRESS ;

41 | devAddrGyr | = BMI055_GYR_ADDRESS ;
42 | }
44 | /*
45 | S p e c i f i c Address C o n s t r u c t o r
46 | */
47 | BMI055 : : BMI055 ( ui n t 8 _ t add ressAcc , ui n t 8 _ t add ressGy ro ) {
48 | devAddrAcc | = add re s sAcc ;
49 | devAddrGyr | = add ressGy ro ;
50 | }
52 | /*
53 | I n i t i a l i z e wi th max Range f o r Acc and Gyro
54 | */
55 | void BMI055 : : i n i t i a l i z e ( ) {
56 | se tRangeAcc (BMI055_ACC_RANGE_16G) ;
57 | se tRangeGyr (BMI055_GYR_RANGE_2000) ;
58 | // se tBandwid th ( ) ;
59 | }
61 | /*
62 | V e r i f y the I2C c onnec ti on .
63 | Make su re the devi ce i s connec ted and re spond s as e xpec ted .
64 | True i f c onnec ti on i s v ali d , f a l s e o t he rwi se .
65 | Thi s r e g i s t e r s a re used t o v e r i f y the i d e n t i t y o f the devi ce
66 | BMI055_ACC_BGW_CHIPID | = 0xFA
67 | BMI055_GYR_CHIP_ID | = 0x0F
68 | */
69 | bool BMI055 : : t e s tC o n n e c ti o n ( ) {
70 | r e t u r n ( ( ge tDevice IDAcc ( ) == 0xFA ) && ( ge tDevice IDGy r ( ) == 0x0F ) ) ;
71 | }
73 | ui n t 8 _ t BMI055 : : ge tDevice IDAcc ( ) {
74 | I2Cdev : : re adBy te ( devAddrAcc , BMI055_ACC_BGW_CHIPID , b u f f e r ) ;
75 | r e t u r n b u f f e r [ 0 ] ;
76 | }
78 | ui n t 8 _ t BMI055 : : ge tDevice IDGy r ( ) {
79 | I2Cdev : : re adBy te ( devAddrGyr , BMI055_GYR_CHIP_ID , b u f f e r ) ;
80 | r e t u r n b u f f e r [ 0 ] ;
81 | }
83 | /*
84 | Se t Acc F u l l Range
85 | 0011 = +−2g
86 | 0101 = +−4g
87 | 1000 = +−8g
88 | 1100 = +−16g
89 | */
90 | void BMI055 : : se tRangeAcc ( ui n t 8 _ t range ) {
91 | I2Cdev : : w r i t e B i t s ( devAddrAcc , BMI055_ACC_PMU_RANGE, BMI055_ACC_RANGE_BIT ,
| BMI055_ACC_RANGE_LENGTH , range ) ;
92 | }
94 | /*
95 | Se t Gyr F u l l Range
96 | 000 = +−2000Â° / s
97 | 001 = +−1000Â° / s
98 | 010 = +− 500Â° / s
99 | 011 = +− 250Â° / s
100 | 100 = +− 125Â° / s
101 | */
102 | void BMI055 : : se tRangeGyr ( ui n t 8 _ t range ) {
103 | I2Cdev : : w r i t e B i t s ( devAddrGyr , BMI055_GYR_RANGE , BMI055_GYR_RANGE_BIT , BMI055_GYR_RANGE_LENGTH ,
| range ) ;
104 | }
106 | void BMI055 : : se tBandwid thAcc ( ui n t 8 _ t bandwidth ) {
107 | I2Cdev : : w r i t e B i t s ( devAddrAcc , BMI055_ACC_PMU_BW, BMI055_ACC_BW_BIT , BMI055_ACC_BW_LENGTH ,
| bandwidth ) ;
108 | }
110 | void BMI055 : : se tBandwid thGyr ( ui n t 8 _ t bandwidth ) {

111 | I2Cdev : : w r i t e B i t s ( devAddrGyr , BMI055_GYR_BW , BMI055_GYR_BW_BIT , BMI055_GYR_BW_LENGTH, bandwidth
| ) ;
112 | }
114 | ui n t 8 _ t BMI055 : : ge tBandwid thAcc ( ) {
115 | I2Cdev : : r e a d Bi t s ( devAddrAcc , BMI055_ACC_PMU_BW, BMI055_ACC_BW_BIT , BMI055_ACC_BW_LENGTH , b u f f e r
| ) ;
116 | r e t u r n b u f f e r [ 0 ] ;
117 | }
119 | ui n t 8 _ t BMI055 : : getBandwidthGyr ( ) {
120 | I2Cdev : : r e a d Bi t s ( devAddrGyr , BMI055_GYR_BW , BMI055_GYR_BW_BIT , BMI055_GYR_BW_LENGTH, b u f f e r ) ;
121 | r e t u r n b u f f e r [ 0 ] ;
122 | }
124 | ui n t 8 _ t BMI055 : : getRangeAcc ( ) {
125 | I2Cdev : : r e a d Bi t s ( devAddrAcc , BMI055_ACC_PMU_RANGE, BMI055_ACC_RANGE_BIT ,
| BMI055_ACC_RANGE_LENGTH , b u f f e r ) ;
126 | r e t u r n b u f f e r [ 0 ] ;
127 | }
129 | ui n t 8 _ t BMI055 : : getRangeGyr ( ) {
130 | I2Cdev : : r e a d Bi t s ( devAddrGyr , BMI055_GYR_RANGE , BMI055_GYR_RANGE_BIT , BMI055_GYR_RANGE_LENGTH ,
| b u f f e r ) ;
131 | r e t u r n b u f f e r [ 0 ] ;
132 | }
134 | void BMI055 : : g e t A c c el e r a t i o n ( ui n t 8 _ t * axLB , ui n t 8 _ t * axHB , ui n t 8 _ t * ayLB , ui n t 8 _ t * ayHB , ui n t 8 _ t *
| azLB , ui n t 8 _ t * azHB ) {
135 | I2Cdev : : re a dBy te s ( devAddrAcc , BMI055_ACC_ACCD_X_LSB , 6 , b u f f e r ) ;
136 | *axLB=( ui n t 8 _ t ) b u f f e r [ 0 ] ;
137 | *axHB=( ui n t 8 _ t ) b u f f e r [ 1 ] ;
139 | *ayLB=( ui n t 8 _ t ) b u f f e r [ 2 ] ;
140 | *ayHB=( ui n t 8 _ t ) b u f f e r [ 3 ] ;
142 | *azLB=( ui n t 8 _ t ) b u f f e r [ 4 ] ;
143 | *azHB=( ui n t 8 _ t ) b u f f e r [ 5 ] ;
145 | }
147 | // // TODO: mask ou t unused b i t s ? si gned i n t e g e r behaves s t r a n g e when b i t s h i f t e d : [1111 1111 1111
| | 0001] >>4 = [1111 1111 1111 1111]
148 | //
149 | // i n t 1 6 _ t BMI055 : : g e t A c c el e r a ti o n X ( ) {
150 | // | I2Cdev : : re a dBy te s ( devAddrAcc , BMI055_ACC_ACCD_X_LSB , 2 , b u f f e r ) ;
151 | // | r e t u r n ( ( ( ( i n t 1 6 _ t ) b u f f e r [ 1 ] ) << 8) | ( i n t 1 6 _ t ) b u f f e r [0] | >> 4) ;
152 | // }
153 | //
154 | // i n t 1 6 _ t BMI055 : : g e t A c c el e r a ti o n Y ( ) {
155 | // | I2Cdev : : re a dBy te s ( devAddrAcc , BMI055_ACC_ACCD_Y_LSB , 2 , b u f f e r ) ;
156 | // | r e t u r n ( ( ( ( i n t 1 6 _ t ) b u f f e r [ 1 ] ) << 8) | ( i n t 1 6 _ t ) b u f f e r [0] | >> 4) ;
157 | // }
158 | //
159 | // i n t 1 6 _ t BMI055 : : g e t A c c el e r a ti o n Z ( ) {
160 | // | I2Cdev : : re a dBy te s ( devAddrAcc , BMI055_ACC_ACCD_Z_LSB , 2 , b u f f e r ) ;
161 | // | r e t u r n ( ( ( ( i n t 1 6 _ t ) b u f f e r [ 1 ] ) << 8) | ( i n t 1 6 _ t ) b u f f e r [0] | >> 4) ;
162 | // }
164 | void BMI055 : : ge tTu rnRa te ( ui n t 8 _ t * gxLB , ui n t 8 _ t * gxHB , ui n t 8 _ t * gyLB , ui n t 8 _ t * gyHB , ui n t 8 _ t * gzLB ,
| | ui n t 8 _ t * gzHB ) {
165 | I2Cdev : : re a dBy te s ( devAddrGyr , BMI055_GYR_RATE_X_LSB , 6 , b u f f e r ) ;
166 | | *gxLB=( ui n t 8 _ t ) b u f f e r [ 0 ] ;
167 | | *gxHB=( ui n t 8 _ t ) b u f f e r [ 1 ] ;
169 | | *gyLB=( ui n t 8 _ t ) b u f f e r [ 2 ] ;
170 | | *gyHB=(i n t 8 _ t ) b u f f e r [ 3 ] ;
172 | | *gzLB=( ui n t 8 _ t ) b u f f e r [ 4 ] ;
173 | | *gzHB=( ui n t 8 _ t ) b u f f e r [ 5 ] ;
174 | }
176 | // i n t 1 6 _ t BMI055 : : ge tTurnRa teX ( ) {
177 | // | I2Cdev : : re a dBy te s ( devAddrGyr , BMI055_GYR_RATE_X_LSB , 2 , b u f f e r ) ;

178 | // | r e t u r n ( ( ( ( i n t 1 6 _ t ) b u f f e r [ 1 ] ) << 8) | b u f f e r [ 0 ] ) ;
179 | // }
180 | //
181 | // i n t 1 6 _ t BMI055 : : ge tTurnRa teY ( ) {
182 | // | I2Cdev : : re a dBy te s ( devAddrGyr , BMI055_GYR_RATE_Y_LSB , 2 , b u f f e r ) ;
183 | // | r e t u r n ( ( ( ( i n t 1 6 _ t ) b u f f e r [ 1 ] ) << 8) | b u f f e r [ 0 ] ) ;
184 | // }
185 | //
186 | // i n t 1 6 _ t BMI055 : : ge tTurnRa teZ ( ) {
187 | // | I2Cdev : : re a dBy te s ( devAddrGyr , BMI055_GYR_RATE_Z_LSB , 2 , b u f f e r ) ;
188 | // | r e t u r n ( ( ( ( i n t 1 6 _ t ) b u f f e r [ 1 ] ) << 8) | b u f f e r [ 0 ] ) ;
189 | // }

## 4.1.2 BMI055.h

1 | // BMI055 I2C Cl a s s header
2 | // 2013/11/05 by Be rnha rd t Sch ae fe r , boen82@gmail . com
3 | // D a t a shee t : h t t p : / /www. bosch−s e n s o r t e c . com/en/homepage/ p roduc t s _3 /6 _ a xi s _ s e n s o r s _ 2 /
i ne r ti al _me a s u reme n t _ u ni t _ 1 /bmi055_1/bmi055
4 | // h t t p : / / ae−b s t . re s o u r ce . bosch . com/media/ p r odu c t s /dokumente/bmi055/BST−BMI055−DS000−06.pd f
5 | // Updates should ( h o p e f ull y ) always be a v a i l a b l e a t h t t p s : / / gi t hu b . com/ j rowbe rg / i 2 c d e v l i b
6 | //
7 | // Changelog :
8 | // | 2013/11/05 − i n i t i a l r e l e a s e
10 | /* ======================= ====================
11 | I2Cdev devi ce l i b r a r y code i s pl aced under the MIT l i c e n s e
12 | C opy ri gh t ( c ) 2011 J e f f Rowberg
14 | Pe rmi s si o n i s hereby gran ted , f r e e o f charge , t o any pe rson o b t ai ni n g a copy
15 | o f t h i s s o f tw a re and a s s o ci a t e d documen ta tion f i l e s ( the " So f twa re " ) , t o de al
16 | i n the So f twa re wi thou t r e s t r i c t i o n , i n cl u di n g wi thou t l i m i t a t i o n the r i g h t s
17 | t o use , copy , modify , merge , pu bli s h , d i s t r i b u t e , s u bli c e n s e , and/ or s e l l
18 | c o pi e s o f the So f tware , and t o pe rmi t pe r s on s t o whom the So f twa re i s
19 | f u r ni s h e d t o do so , s u b j e c t t o the f oll o wi n g c o n di ti o n s :
21 | The above c o p y ri g h t n o ti c e and t h i s pe rmi s si o n n o ti c e s h a l l be i n cl u de d i n
22 | a l l c o pi e s or s u b s t a n t i a l p o r ti o n s o f the So f twa re .
24 | THE SOFTWARE IS PROVIDED "AS IS " , WITHOUT WARRANTY OF ANY KIND , EXPRESS OR
25 | IMPLIED , INCLUDING BUT NOT LIMITED TO THE WARRANTIES OF MERCHANTABILITY ,
26 | FITNESS FOR A PARTICULAR PURPOSE AND NONINFRINGEMENT. IN NO EVENT SHALL THE
27 | AUTHORS OR COPYRIGHT HOLDERS BE LIABLE FOR ANY CLAIM , DAMAGES OR OTHER
28 | L IAB IL ITY , WHETHER IN AN ACTION OF CONTRACT, TORT OR OTHERWISE, ARISING FROM,
29 | OUT OF OR IN CONNECTION WITH THE SOFTWARE OR THE USE OR OTHER DEALINGS IN
30 | THE SOFTWARE.
31 ===============================================
32 | */
34 | #i f n d e f _BMI055_H_
35 | #d e fi n e _BMI055_H_
37 | #i n cl u d e " I2Cdev . h "
39 | #d e fi n e BMI055_ACC_ADDRESS | 0x18 | // d e f a u l t I2C add re s s acc
40 | #d e fi n e BMI055_GYR_ADDRESS | 0x68 | // d e f a u l t I2C add re s s gyro
42 | #d e fi n e BMI055_ACC_ADDRESS_alt | 0x19 | // a l t e r n a t i v e I2C add re s s acc
43 | #d e fi n e BMI055_GYR_ADDRESS_alt | 0x69 | // a l t e r n a t i v e I2C add re s s gyro
45 | #d e fi n e BMI055_ACC_BGW_CHIPID | 0x00 | // Fi xed v alue B11111010 or 0xFA
47 | #d e fi n e BMI055_ACC_ACCD_X_LSB | 0x02
48 | #d e fi n e BMI055_ACC_ACCD_X_MSB | 0x03
49 | #d e fi n e BMI055_ACC_ACCD_Y_LSB | 0x04
50 | #d e fi n e BMI055_ACC_ACCD_Y_MSB | 0x05
51 | #d e fi n e BMI055_ACC_ACCD_Z_LSB | 0x06
52 | #d e fi n e BMI055_ACC_ACCD_Z_MSB | 0x07
53 | #d e fi n e BMI055_ACC_ACCD_TEMP | 0x08
54 | #d e fi n e BMI055_ACC_INT_STATUS_0 | 0x09
55 | #d e fi n e BMI055_ACC_INT_STATUS_1 | 0x0A
56 | #d e fi n e BMI055_ACC_INT_STAUTS_2 | 0x0B
57 | #d e fi n e BMI055_ACC_INT_STATUS_3 | 0x0C

59 | #d e fi n e BMI055_ACC_FOFO_STATUS | 0x0E
60 | #d e fi n e BMI055_ACC_PMU_RANGE | 0x0F
61 | #d e fi n e BMI055_ACC_PMU_BW | 0x10
62 | #d e fi n e BMI055_ACC_PMU_LPW | 0x11
63 | #d e fi n e BMI055_ACC_PMU_LOW_POWER | 0x12
64 | #d e fi n e BMI055_ACC_ACCD_HBW | 0x13
65 | #d e fi n e BMI055_ACC_BGW_SOFTRESET | 0x14
67 | #d e fi n e BMI055_ACC_INT_EN_0 | 0x16
68 | #d e fi n e BMI055_ACC_INT_EN_1 | 0x17
69 | #d e fi n e BMI055_ACC_INT_EN_2 | 0x18
70 | #d e fi n e BMI055_ACC_INT_MAP_0 | 0x19
71 | #d e fi n e BMI055_ACC_INT_MAP_1 | 0x1A
72 | #d e fi n e BMI055_ACC_INT_MAP_2 | 0x1B
73 | #d e fi n e BMI055_ACC_INT_SRC | 0x1E
74 | #d e fi n e BMI055_ACC_INT_OUT_CTRL | 0x20
75 | #d e fi n e BMI055_ACC_INT_RST_LATCH | 0x21
76 | #d e fi n e BMI055_ACC_INT_0 | 0x22
77 | #d e fi n e BMI055_ACC_INT_1 | 0x23
78 | #d e fi n e BMI055_ACC_INT_2 | 0x24
79 | #d e fi n e BMI055_ACC_INT_3 | 0x25
80 | #d e fi n e BMI055_ACC_INT_4 | 0x26
81 | #d e fi n e BMI055_ACC_INT_5 | 0x27
82 | #d e fi n e BMI055_ACC_INT_6 | 0x28
83 | #d e fi n e BMI055_ACC_INT_7 | 0x29
84 | #d e fi n e BMI055_ACC_INT_8 | 0x2A
85 | #d e fi n e BMI055_ACC_INT_9 | 0x2B
86 | #d e fi n e BMI055_ACC_INT_A | 0x2C
87 | #d e fi n e BMI055_ACC_INT_B | 0x2D
88 | #d e fi n e BMI055_ACC_INT_C | 0x2E
89 | #d e fi n e BMI055_ACC_INT_D | 0x2F
90 | #d e fi n e BMI055_ACC_FIFO_CONFIG_0 | 0x30
91 | #d e fi n e BMI055_ACC_PMU_SELF_TEST | 0x32
92 | #d e fi n e BMI055_ACC_TRIM_NVM_CTRL | 0x33
93 | #d e fi n e BMI055_ACC_BGW_SPI3_WDT | 0x34
94 | #d e fi n e BMI055_ACC_OFC_CTRL | 0x36
95 | #d e fi n e BMI055_ACC_OFC_SETTING | 0x37
96 | #d e fi n e BMI055_ACC_OFC_OFFSET_X | 0x38
97 | #d e fi n e BMI055_ACC_OFC_OFFSET_Y | 0x39
98 | #d e fi n e BMI055_ACC_OFC_OFFSET_Z | 0x3A
99 | #d e fi n e BMI055_ACC_TRIM_GP0 | 0x3B
100 | #d e fi n e BMI055_ACC_TRIM_GP1 | 0x3C
101 | #d e fi n e BMI055_ACC_FIFO_CONFIG_1 | 0x3E
102 | #d e fi n e BMI055_ACC_FIFO_DATA | 0x3F
104 | #d e fi n e BMI055_ACC_RANGE_BIT | 3
105 | #d e fi n e BMI055_ACC_RANGE_LENGTH | 4
106 | #d e fi n e BMI055_ACC_BW_BIT | 4
107 | #d e fi n e BMI055_ACC_BW_LENGTH | 5
109 | #d e fi n e BMI055_ACC_RANGE_2G | 3 | // B0011
110 | #d e fi n e BMI055_ACC_RANGE_4G | 5 | // B0101
111 | #d e fi n e BMI055_ACC_RANGE_8G | 8 | // B1000
112 | #d e fi n e BMI055_ACC_RANGE_16G | 12 | // B1100
114 | #d e fi n e BMI055_ACC_BW_BIT | 4
115 | #d e fi n e BMI055_ACC_BW_LENGTH | 5
117 | #d e fi n e BMI055_ACC_BW_7 | 8 | // 01000b ’ 7. 8 1 Hz
118 | #d e fi n e BMI055_ACC_BW_15 | 9 | // ’01001b 15.63 Hz
119 | #d e fi n e BMI055_ACC_BW_31 | 10 | // 01010b 31.25 Hz
120 | #d e fi n e BMI055_ACC_BW_62 | 11 | // ’01011b 62.5 Hz
121 | #d e fi n e BMI055_ACC_BW_125 | 12 | // ’01100b 125 Hz
122 | #d e fi n e BMI055_ACC_BW_250 | 13 | // ’01101b 250 Hz
123 | #d e fi n e BMI055_ACC_BW_500 | 14 | // ’01110b 500 Hz
124 | #d e fi n e BMI055_ACC_BW_1000 | 15 | // ’01111b ’1000 Hz
127 | #d e fi n e BMI055_ACC_DATA_HIGH_BW_BIT | 7
128 | #d e fi n e BMI055_ACC_DATA_HIGH_BW_LENGTH | 1
129 | #d e fi n e BMI055_ACC_DATA_HIGH_BW | 1
131 | // GYRO REGISTER

133 | #d e fi n e BMI055_GYR_CHIP_ID | 0x00 | // f i x e d v alue 0x0F
134 | #d e fi n e BMI055_GYR_RATE_X_LSB | 0x02
135 | #d e fi n e BMI055_GYR_RATE_X_MSB | 0x03
136 | #d e fi n e BMI055_GYR_RATE_Y_LSB | 0x04
137 | #d e fi n e BMI055_GYR_RATE_Y_MSB | 0x05
138 | #d e fi n e BMI055_GYR_RATE_Z_LSB | 0x06
139 | #d e fi n e BMI055_GYR_RATE_Z_MSB | 0x07
141 | #d e fi n e BMI055_GYR_INT_STATUS_0 | 0x09
142 | #d e fi n e BMI055_GYR_INT_STATUS_1 | 0x0A
143 | #d e fi n e BMI055_GYR_INT_STAUTS_2 | 0x0B
144 | #d e fi n e BMI055_GYR_INT_STATUS_3 | 0x0C
146 | #d e fi n e BMI055_GYR_FIFO_STATUS | 0x0E
147 | #d e fi n e BMI055_GYR_RANGE | 0x0F
148 | #d e fi n e BMI055_GYR_BW | 0x10
149 | #d e fi n e BMI055_GYR_LPM1 | 0x11
150 | #d e fi n e BMI055_GYR_LPM2 | 0x12
151 | #d e fi n e BMI055_GYR_RATE_HBW | 0x13
152 | #d e fi n e BMI055_GYR_BGW_SOFTRESET | 0x14
153 | #d e fi n e BMI055_GYR_INT_EN_0 | 0x15
154 | #d e fi n e BMI055_GYR_INT_EN_1 | 0x16
155 | #d e fi n e BMI055_GYR_INT_MAP_0 | 0x17
156 | #d e fi n e BMI055_GYR_INT_MAP_1 | 0x18
157 | #d e fi n e BMI055_GYR_INT_MAP_2 | 0x19
158 | #d e fi n e BMI055_GYR_INT_DATA_SOURCE | 0x1A
159 | #d e fi n e BMI055_GYR_MOT_THRES_DATA_SOURCE | 0x1B
160 | #d e fi n e BMI055_GYR_MOT_INT_EN | 0x1C
162 | #d e fi n e BMI055_GYR_FIFO_WM_EN | 0x1E
164 | #d e fi n e BMI055_GYR_INT_RST_LATCH | 0x21
165 | #d e fi n e BMI055_GYR_HIGH_TH_X | 0x22
166 | #d e fi n e BMI055_GYR_HIGH_DUR_X | 0x23
167 | #d e fi n e BMI055_GYR_HIGH_TH_Y | 0x24
168 | #d e fi n e BMI055_GYR_HIGH_DUR_Y | 0x25
169 | #d e fi n e BMI055_GYR_HIGH_TH_Z | 0x26
170 | #d e fi n e BMI055_GYR_HIGH_DUR_Z | 0x27
172 | #d e fi n e BMI055_GYR_SOC | 0x31
173 | #d e fi n e BMI055_GYR_A_FOC | 0x32
174 | #d e fi n e BMI055_GYR_TRIM_NVM_CTRL | 0x33
175 | #d e fi n e BMI055_GYR_BGW_SPI3_WDT | 0x34
177 | #d e fi n e BMI055_GYR_OFC1 | 0x36
178 | #d e fi n e BMI055_GYR_OFC2 | 0x37
179 | #d e fi n e BMI055_GYR_OFC3 | 0x38
180 | #d e fi n e BMI055_GYR_OFC4 | 0x39
181 | #d e fi n e BMI055_GYR_TRIM_GP0 | 0x3A
182 | #d e fi n e BMI055_GYR_TRIM_GP1 | 0x3B
183 | #d e fi n e BMI055_GYR_BIST | 0x3C
184 | #d e fi n e BMI055_GYR_FIFO_CONFIG_0 | 0x3D
185 | #d e fi n e BMI055_GYR_FIFO_CONFIG_1 | 0x3E
186 | #d e fi n e BMI055_GYR_FIFO_DATA | 0x3F
188 | // GYR RANGE
190 | #d e fi n e BMI055_GYR_RANGE_BIT | 2
191 | #d e fi n e BMI055_GYR_RANGE_LENGTH | 3
193 | #d e fi n e BMI055_GYR_RANGE_2000 | 0 | // B000
194 | #d e fi n e BMI055_GYR_RANGE_1000 | 1 | // B001
195 | #d e fi n e BMI055_GYR_RANGE_500 | 2 | // B010
196 | #d e fi n e BMI055_GYR_RANGE_250 | 3 | // B011
197 | #d e fi n e BMI055_GYR_RANGE_125 | 4 | // B100
199 | // GYR BW
200 | #d e fi n e BMI055_GYR_BW_BIT | 3
201 | #d e fi n e BMI055_GYR_BW_LENGTH | 4
203 | #d e fi n e BMI055_GYR_BW_32 | 7 | // | 0111 | 20 100 Hz BW 32 Hz
204 | #d e fi n e BMI055_GYR_BW_64 | 6 | // â 0 1 1 0 | 10 200 Hz BW 64 Hz
205 | #d e fi n e BMI055_GYR_BW_12 | 5 | // â 0 1 0 1 | 20 100 Hz BW 12 Hz
206 | #d e fi n e BMI055_GYR_BW_23 | 4 | // â 0 1 0 0 | 10 200 Hz BW 23 Hz

207 | #d e fi n e BMI055_GYR_BW_47 | 3 | // â 0 0 1 1 | 5 | 400 Hz BW 47 Hz
208 | #d e fi n e BMI055_GYR_BW_116 | 2 | // â 0 0 1 0 | 2 1000 Hz BW 116 Hz
209 | #d e fi n e BMI055_GYR_BW_230 | 1 | // â 0 0 0 1 | 0 2000 Hz BW 230 Hz
210 | #d e fi n e BMI055_GYR_BW_523 | 0 | // â 0 0 0 0 | 0 2000 Hz U n f i l t e r e d
| (523Hz)
213 | #d e fi n e BMI055_GYR_BW_BIT | 3
214 | #d e fi n e BMI055_GYR_BW_LENGTH | 4
215 | #d e fi n e BMI055_GYR_BW_32HZ | 7 | // B0111
216 | #d e fi n e BMI055_GYR_BW_64HZ | 6 | // B0111
217 | #d e fi n e BMI055_GYR_BW_12HZ | 5 | // B0110
218 | #d e fi n e BMI055_GYR_BW_23HZ | 4 | // B0101
219 | #d e fi n e BMI055_GYR_BW_47HZ | 3 | // B0011
220 | #d e fi n e BMI055_GYR_BW_116HZ | 2 | // B0010
221 | #d e fi n e BMI055_GYR_BW_230HZ | 1 | // B0001
222 | #d e fi n e BMI055_GYR_BW_523HZ | 0 | // B0000
224 | // TODO
226 | // c l a s s
228 | c l a s s BMI055 {
229 | p u bli c :
230 | BMI055 ( ) ;
231 | BMI055 ( ui n t 8 _ t add ressAcc , ui n t 8 _ t add ressGy ro ) ;
233 | void i n i t i a l i z e ( ) ;
234 | bool t e s tC o n n e c ti o n ( ) ;
236 | // CHIP_ID r e g i s t e r
237 | ui n t 8 _ t ge tDevice IDAcc ( ) ;
238 | ui n t 8 _ t ge tDevice IDGy r ( ) ;
240 | // AXIS r e g i s t e r s
241 | void g e t A c c el e r a t i o n ( ui n t 8 _ t * , ui n t 8 _ t * , ui n t 8 _ t * , ui n t 8 _ t * , ui n t 8 _ t * , ui n t 8 _ t * ) ;
242 | i n t 1 6 _ t g e t A c c el e r a ti o n X ( ) ;
243 | i n t 1 6 _ t g e t A c c el e r a ti o n Y ( ) ;
244 | i n t 1 6 _ t g e t A c c el e r a ti o n Z ( ) ;
246 | void ge tTu rnRa te ( ui n t 8 _ t * , ui n t 8 _ t * , ui n t 8 _ t * , ui n t 8 _ t * , ui n t 8 _ t * , ui n t 8 _ t * ) ;
247 | i n t 1 6 _ t ge tTurnRa teX ( ) ;
248 | i n t 1 6 _ t ge tTurnRa teY ( ) ;
249 | i n t 1 6 _ t ge tTurnRa teZ ( ) ;
251 | // Range & Bandwidth R e g i s t e r s
252 | ui n t 8 _ t getRangeAcc ( ) ;
253 | void se tRangeAcc ( ui n t 8 _ t range ) ;
254 | ui n t 8 _ t ge tBandwid thAcc ( ) ;
255 | void se tBandwid thAcc ( ui n t 8 _ t bandwidth ) ;
256 | ui n t 8 _ t getRangeGyr ( ) ;
257 | void se tRangeGyr ( ui n t 8 _ t range ) ;
258 | ui n t 8 _ t getBandwidthGyr ( ) ;
259 | void se tBandwid thGyr ( ui n t 8 _ t bandwidth ) ;
261 | p r i v a t e :
262 | ui n t 8 _ t devAddrAcc ;
263 | ui n t 8 _ t devAddrGyr ;
264 | ui n t 8 _ t b u f f e r [ 6 ] ;
265 | } ;
267 | #e n di f /* _BMI055_H_ */

## 4.1.3 I2Cdev

### https://github.com/jrowberg/i2cdevlib/blob/master/Arduino/I2Cdev/I2Cdev.h

## 4.1.4 MAX17048

### https://github.com/libpropeller/libpropeller/blob/master/libpropeller/max17048/max17048.h

# Datenblatter ¨

[1] Bosch Sensortec shuttle-board BMI055 is a PCB with a BMI055 Inertial Measurement Unit (IMU) mounted on it.
[2] ESP-12F WiFi Module.
