pinguinonice/BetaBMI055/v2/code/test_BETA/matlab/acc_allan_deviation.png

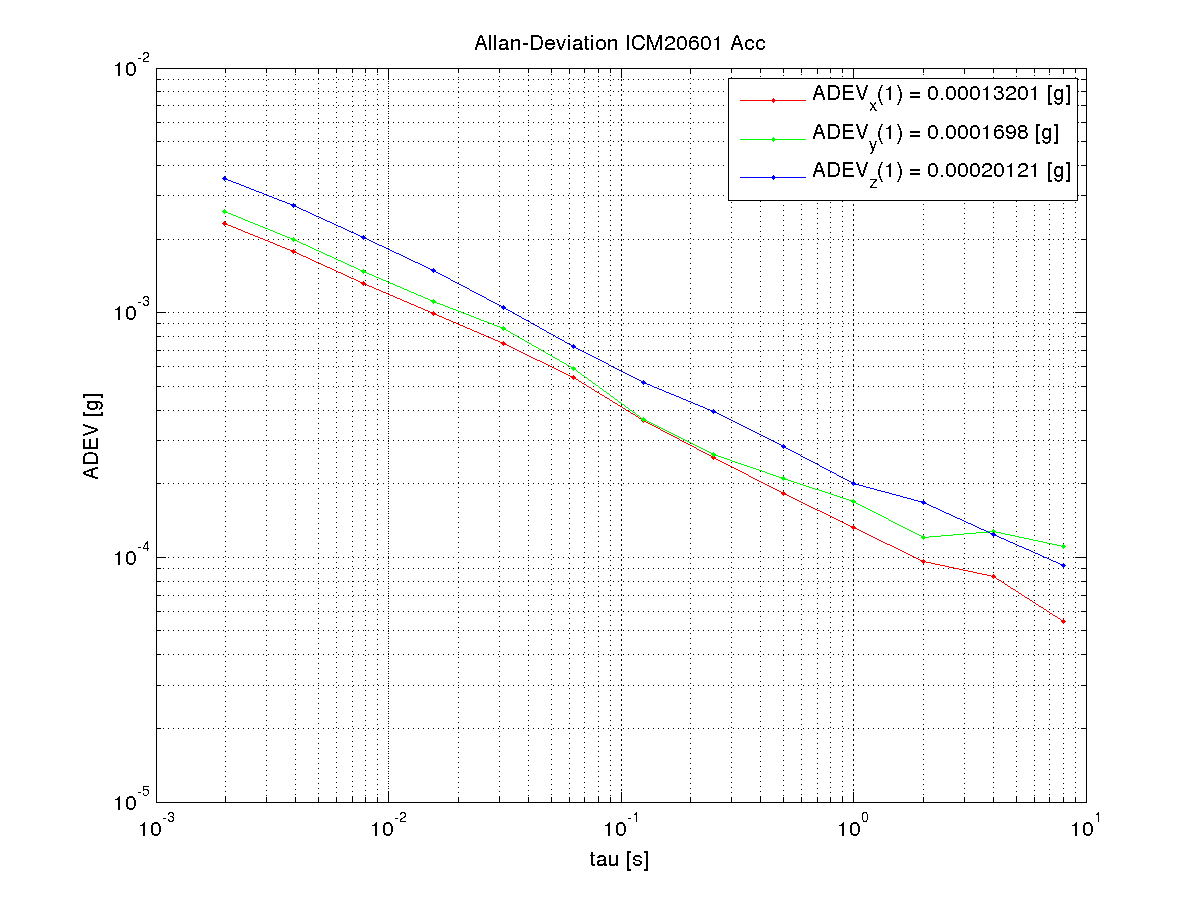
v2/code/test_BETA/matlab/acc_allan_deviation.png
