pinguinonice/BetaBMI055/v2/code/test_BETA/matlab/gyr_allan_deviation.png

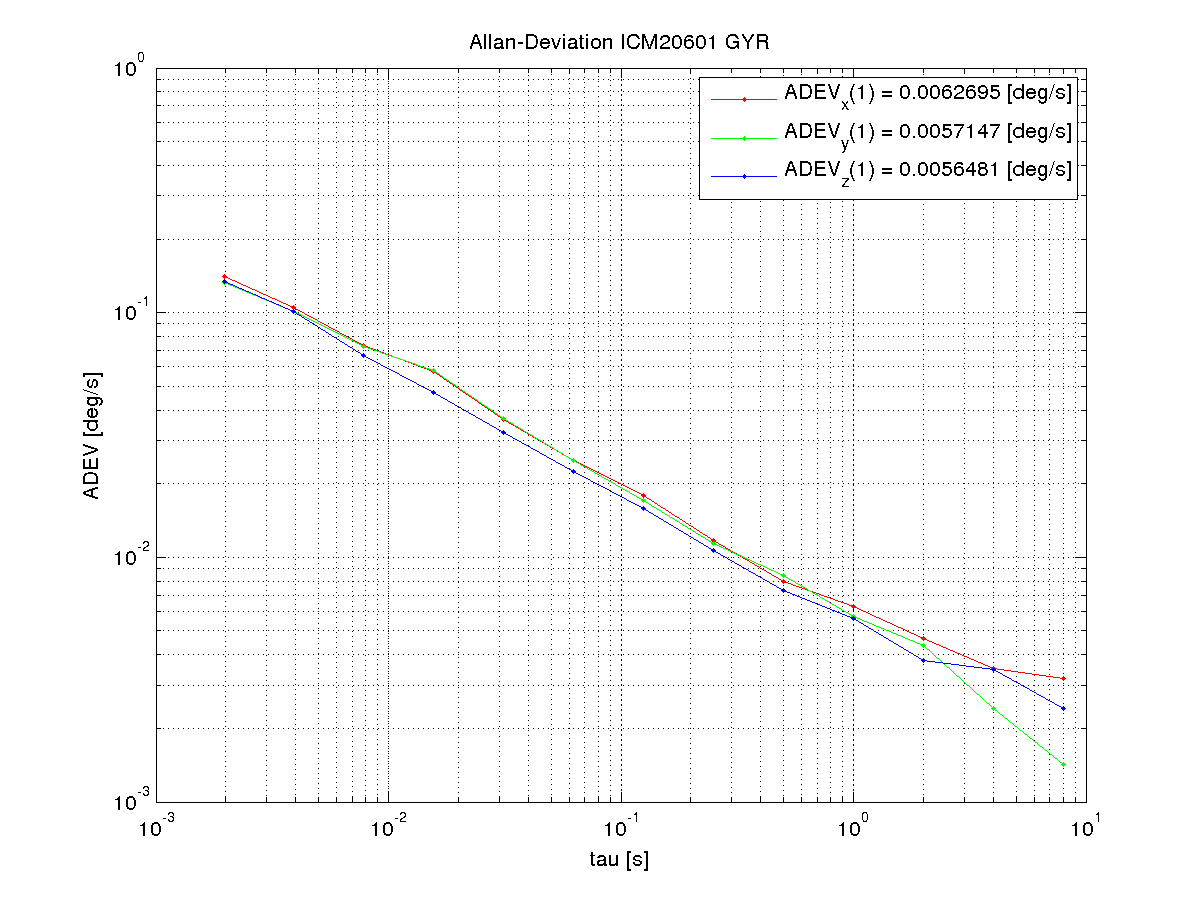
v2/code/test_BETA/matlab/gyr_allan_deviation.png
