pinguinonice/BetaBMI055/v2/code/test_BETA/matlab/rohdaten.png

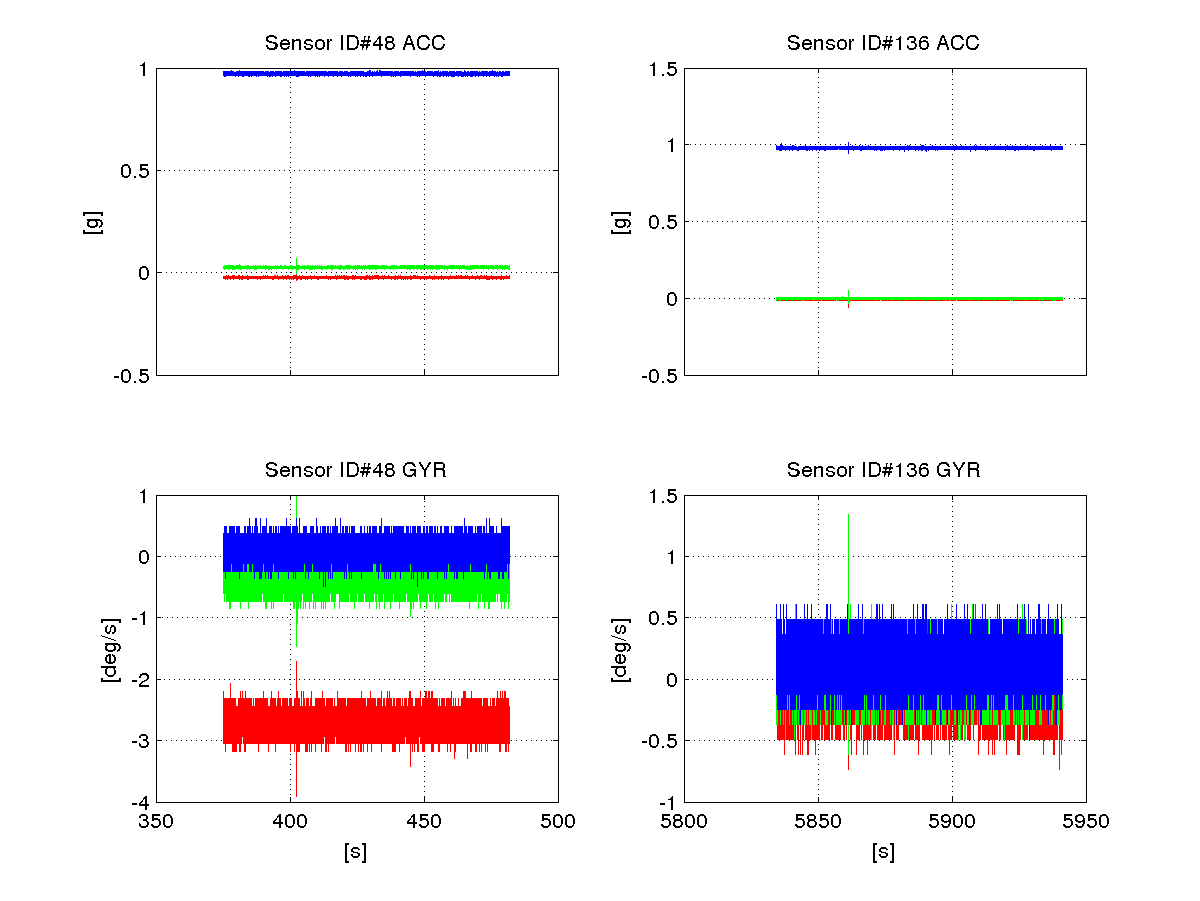
v2/code/test_BETA/matlab/rohdaten.png
