pinguinonice/BetaBMI055/v2/images/BetaICMRev020.pdf

50.0

35.7

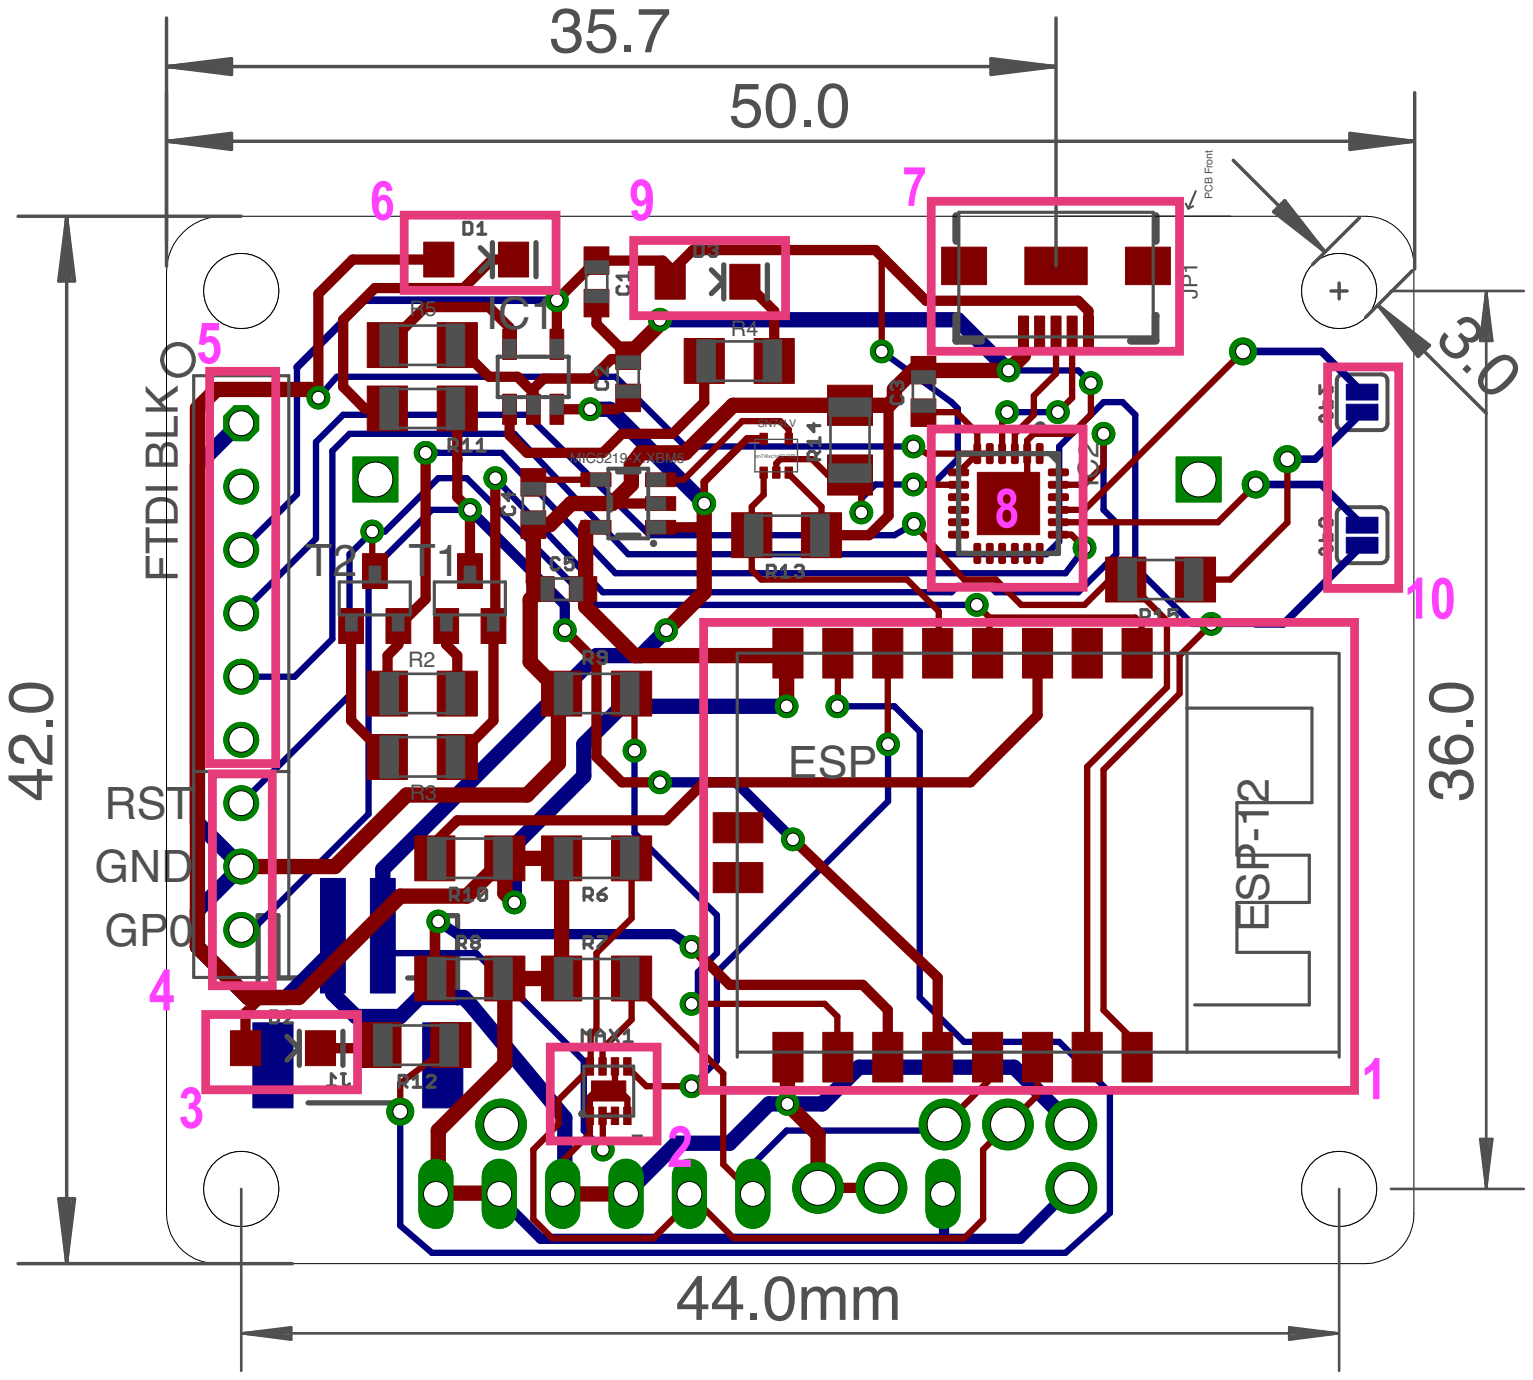
[picture p8: page 1]
ESP; GND; PCB Front; RST; MIC5219-X.XBM5

sn74lvc1g32 DRL | 8
