pinguinonice/BetaBMI055/v2/images/BetaICMschRev015.pdf

3/5
3/6

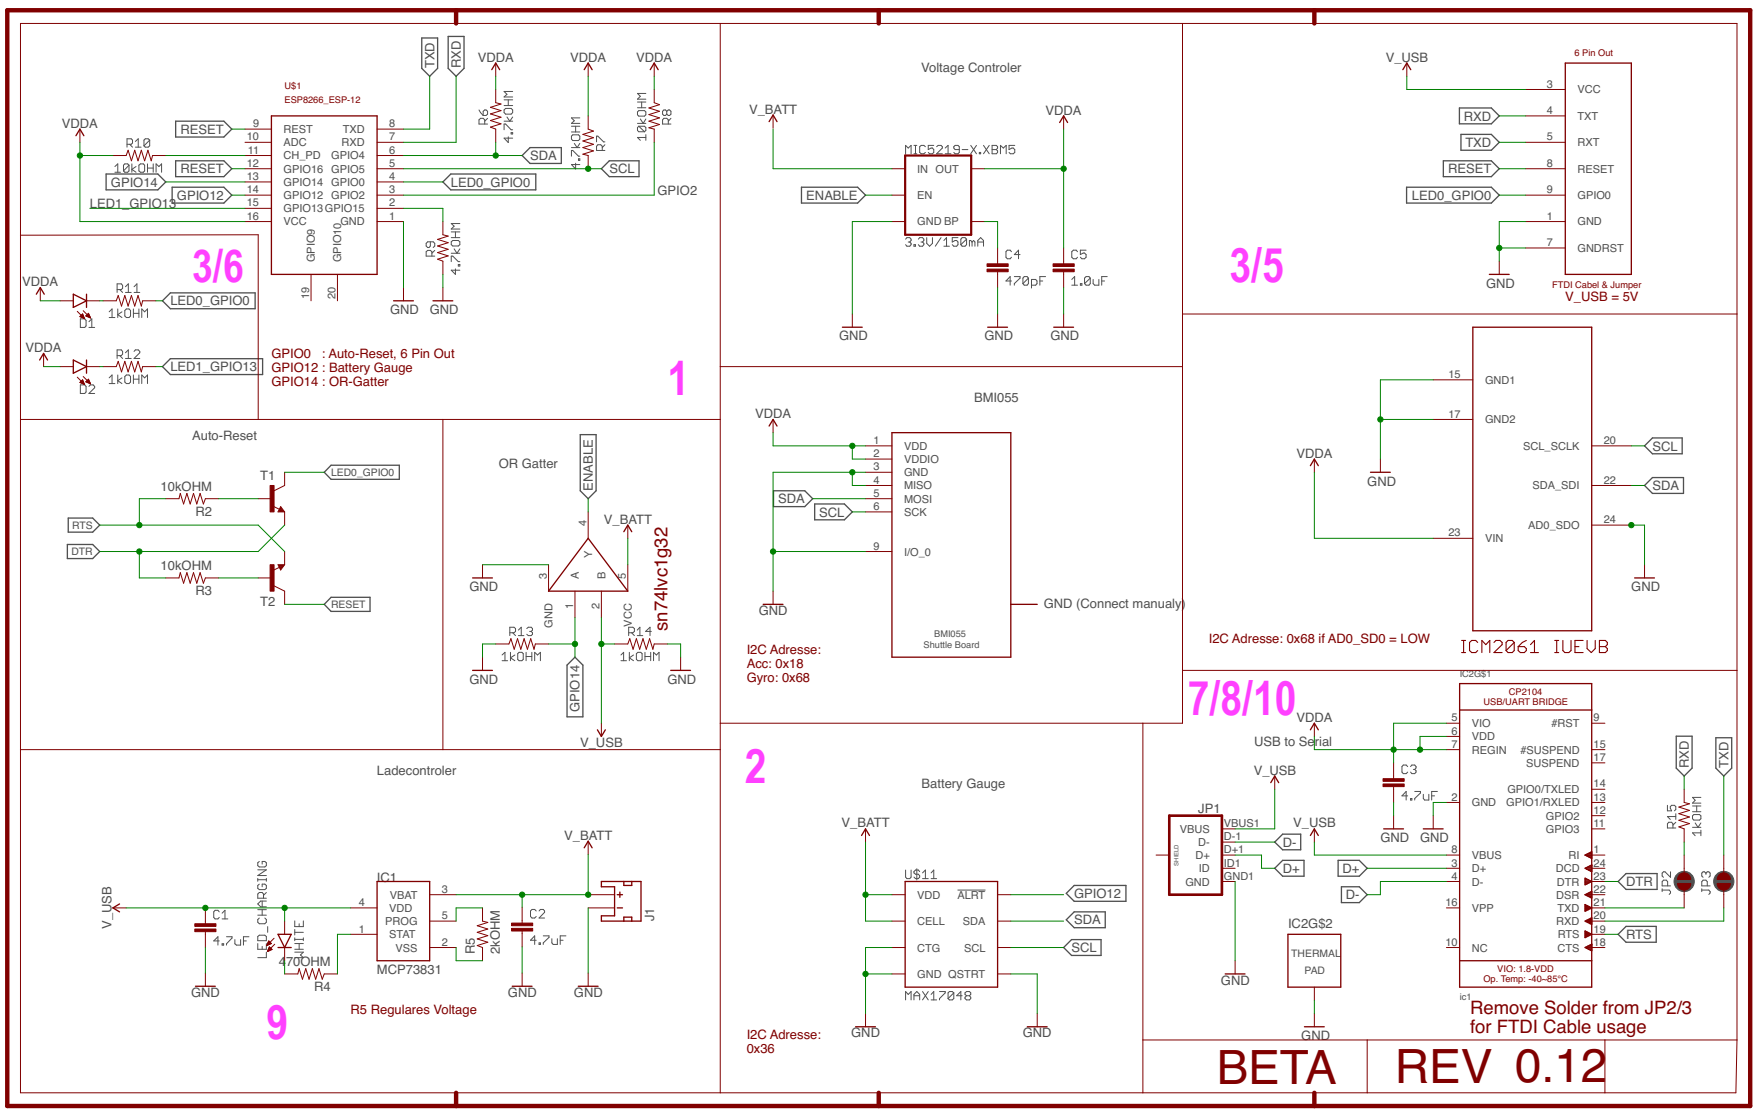
[picture p9: page 1]
MCP73831; GND; V_USB; V_BATT; 2kOHM; 470OHM; 10kOHM; VDDA; GND GND; BMI055; Ladecontroler; Battery Gauge; Voltage Controler; OR Gatter; VDD 4; STAT 1; VBAT; PROG; VSS; ALRT; CELL; CTG; GND QSTRT; SCL; SDA; VDD; VCC 5; GND 3; GND1 ID; VBUS; VBUS1; SHIELD; OUT; #RST; #SUSPEND; CTS; DCD; DSR; 22 DTR; GND 2; GPIO0/TXLED; GPIO1/RXLED; GPIO2; GPIO3; REGIN 7; RTS; 19 RXD; SUSPEND; TXD; VBUS 8; VDD 6; VIO 5; VPP 16; THERMAL PAD; GND1 15; GND2 17; SCL_SCLK; SDA_SDI; VIN 23; AD0_SDO; 1 GPIO15; 2 GPIO2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

FTDI Cabel & Jumper
V_USB = 5V

GPIO0 : Auto-Reset, 6 Pin Out
GPIO12 : Battery Gauge
GPIO14 : OR-Gatter

Auto-Reset T1 T2

SDA | SCL | MOSI 5 SCK 6 I/O_0 9

GND (Connect manualy)

I2C Adresse: 0x68 if AD0_SD0 = LOW I2C Adresse:

USB/UART BRIDGE

USB to Serial

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
