pinguinonice/BetaBMI055/v2/images/BetaICMRev020 copy.pdf

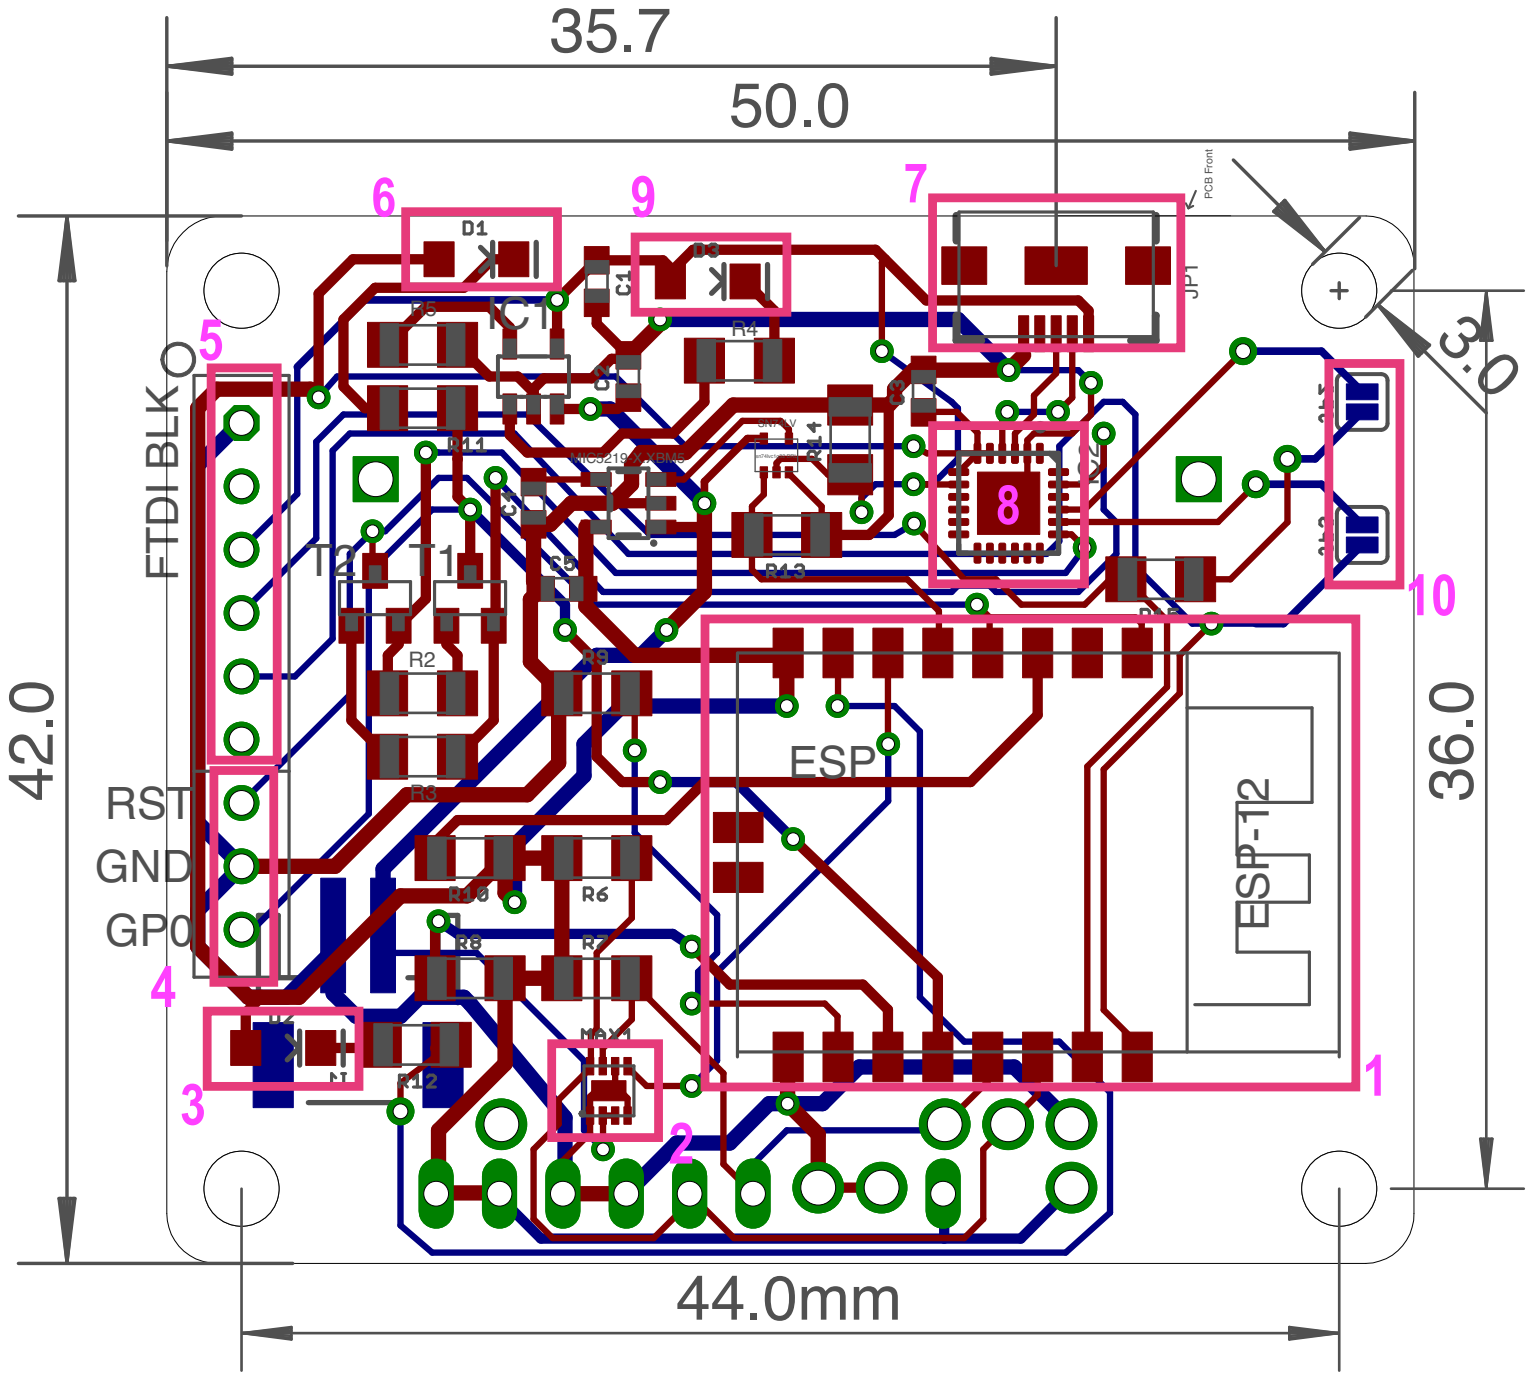
[picture p10: page 1]

sn74lvc1g32 DRL
